thkrz/SenMei3000/tools/ryujin/Ryujin.png

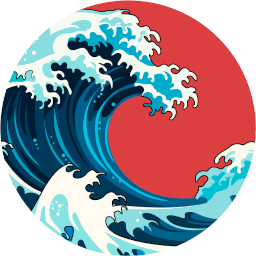
tools/ryujin/Ryujin.png
