thkrz/SenMei3000/www/html/fig/MainPro.png

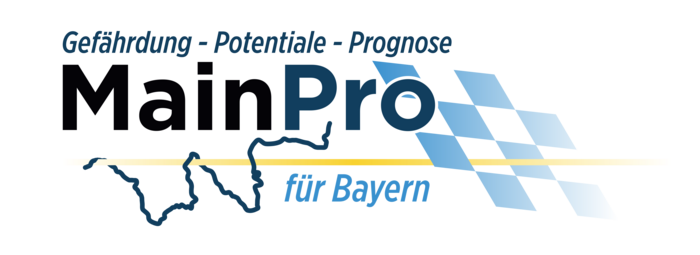
www/html/fig/MainPro.png
