thkrz/SenMei3000/pieces.xlsx

Sheet: Stückliste
Komponente | Bezeichnung | Stückpreis | Menge | Gesamt | Anzahl Stationen
Platine A | https://aisler.net/julius-maximilian-universitat-wurzburg/messstation/ryujin |  | 10 | 1287.21 €
Gehäuse B | https://taf-case.de/TAF-CASE-200-Staub-und-wasserdicht-IP67/1000000082 | 49.90 € | 10 | 499.00 €
MCU | https://www.reichelt.de/de/de/shop/produkt/arduino_mkr_nb_1500_samd21_cortex-m0_32_bit_arm-286746 | 83.60 € | 10 | 836.00 €
Buchse | https://www.reichelt.de/de/de/shop/produkt/einbausteckverbinder_m8_4_pol_kupplung_0_5_m-223096 | 7.55 € | 70 | 528.50 €
Buchse Solar | https://www.reichelt.de/de/de/shop/produkt/quicklock-einbaukupplung_-_groesse_12_2_pol-239487 | 3.45 € | 10 | 34.50 €
Solarpanel | https://solarv.de/enjoysolar-Monokristallines-Solarmodul-20W-12V-2-adriges-Solarkabel-1m1mm | 27.95 € | 0 | 0.00 €
Batterie | https://www.conrad.de/de/p/vision-akkus-cp12120d-cp12120d-bleiakku-12-v-12-ah-blei-vlies-agm-b-x-h-x-t-151-x-101-x-98-mm-flachstecker-6-35-mm-w-377145.html | 59.99 € | 0 | 0.00 €
 |  |  |  | 3185.21 €
 |  |  |  | 318.52 €

Sheet: Eq
THERMISTOR |  |  | V_BAT
V_REF | 3.3 |  | V_BAT | 13.3 |  |  | L | 2.3 | 13.8
RTH_COLD | 42.47 | k | R1 | 82.00 | k |  | T | 0
RTH_HOT | 3.02 | k | R2 | 437.33 | k | 390
V_LTF | 2
V_TCO | 1 |  | V_REAL | 12.09
^
RT1 | 5.36 | k
RT2 | 10.24 | k | V_MPPSET
 |  |  | V_MMPSET | 17.83
 |  |  | R3 | 499
 |  |  | R4 | 36
