thkrz/SenMei3000/kicad/Ryujin/3dmodels/AS11CH.stp

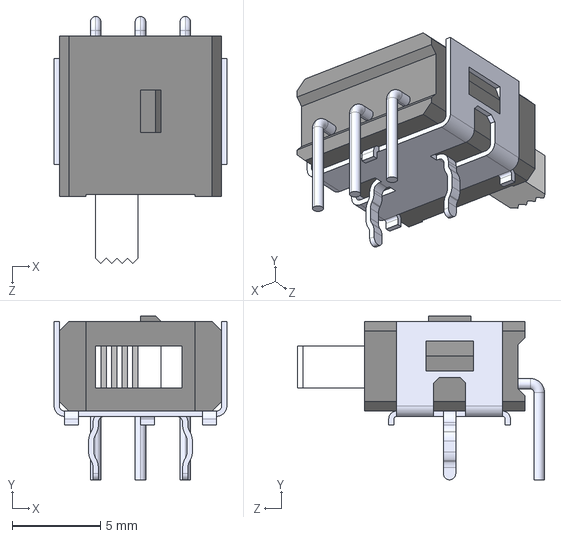
[picture p3: CAD file, 2025-09-05]
kicad/Ryujin/3dmodels/AS11CH.stp
9.80 x 9.28 x 14.0 mm
