thkrz/SenMei3000/kicad/SonTinh/3dmodels/STC31-C-R3.stp

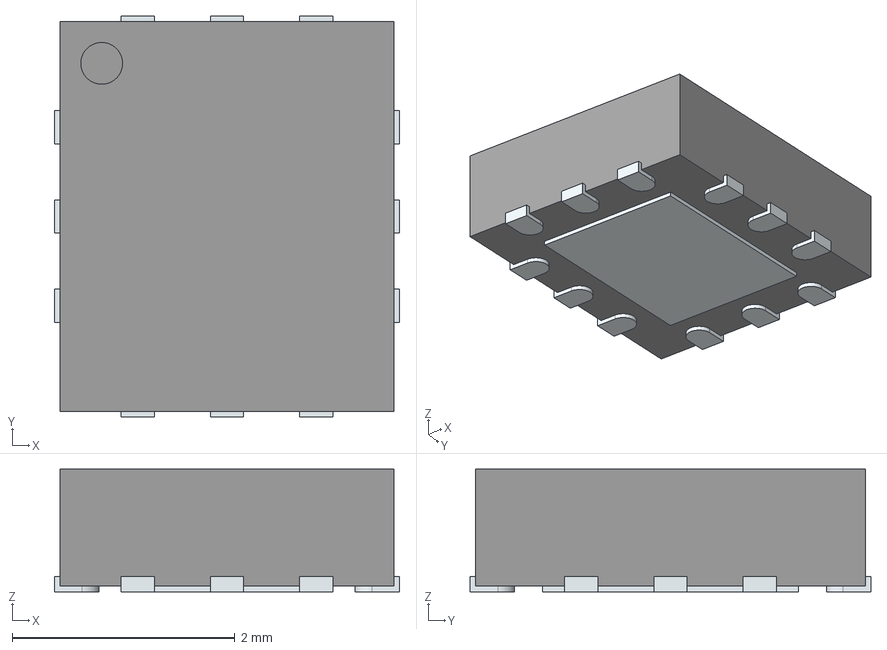
[picture p4: CAD file, 2025-08-25]
kicad/SonTinh/3dmodels/STC31-C-R3.stp
3.10 x 3.60 x 1.10 mm
ThermalPin
PinsArrayLR
PinsArrayTB
