thkrz/SenMei3000/kicad/Ryujin/3dmodels/EEF-CX0J221R.stp

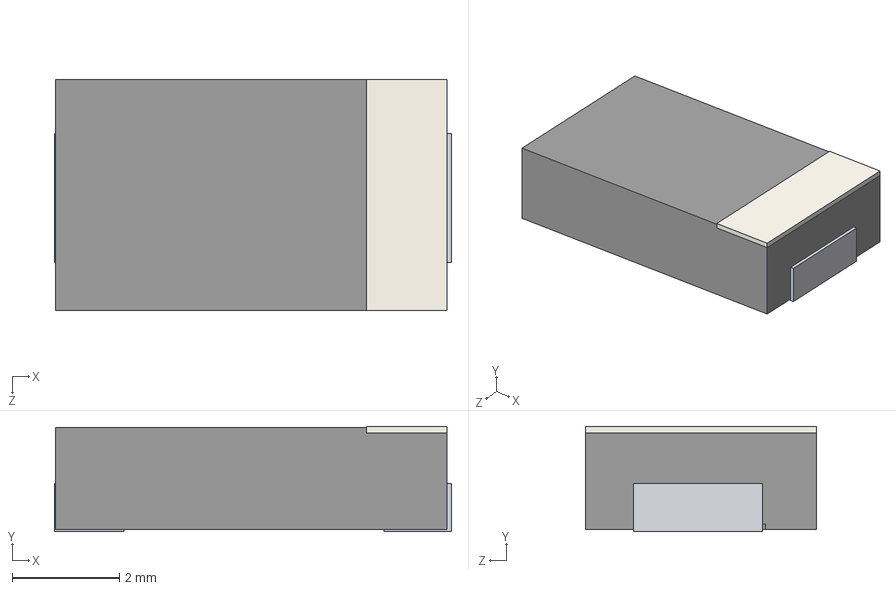
[picture p5: CAD file, 2025-09-04]
kicad/Ryujin/3dmodels/EEF-CX0J221R.stp
7.40 x 1.96 x 4.30 mm
EEFSX0D181ER_4
EEFSX0D181ER_3
