thkrz/SenMei3000/kicad/SonTinh/3dmodels/SHT35-DIS-F2.5kS.stp

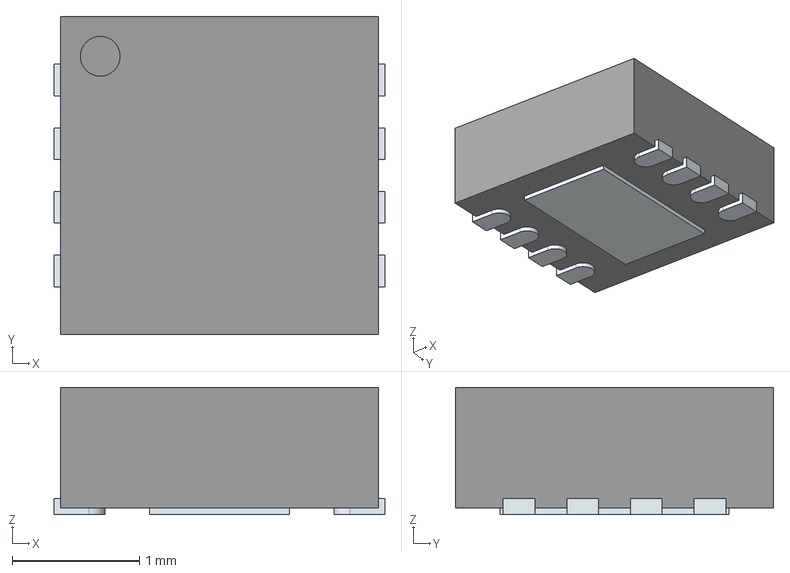
[picture p6: CAD file, 2025-08-25]
kicad/SonTinh/3dmodels/SHT35-DIS-F2.5kS.stp
2.60 x 2.50 x 1.00 mm
ThermalPin
PinsArrayLR
