thkrz/SenMei3000/kicad/Ryujin/3dmodels/T522V227M006ATE025.stp

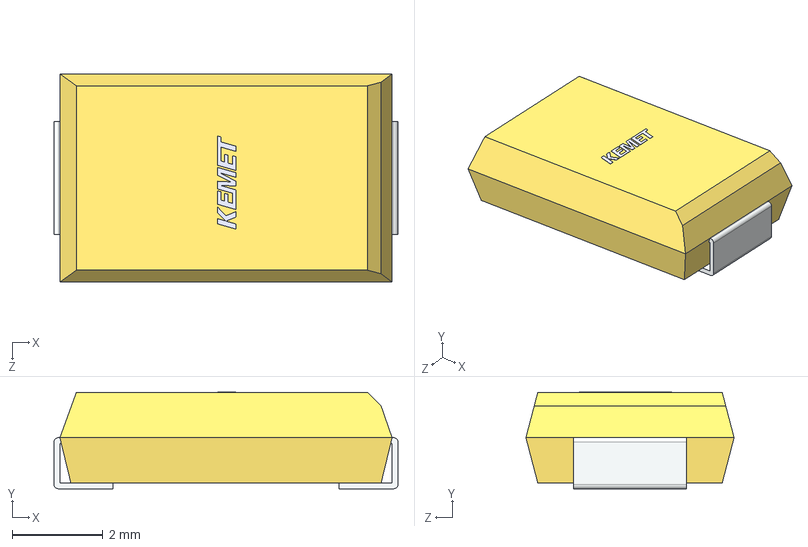
[picture p7: CAD file, 2025-09-04]
kicad/Ryujin/3dmodels/T522V227M006ATE025.stp
7.60 x 2.14 x 4.60 mm
