thkrz/SenMei3000/kicad/SonTinh/3dmodels/BMP384.stp

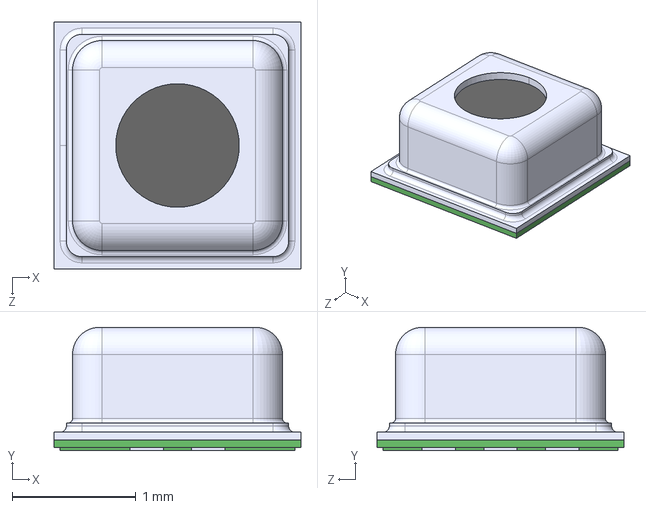
[picture p8: CAD file, 2025-08-25]
kicad/SonTinh/3dmodels/BMP384.stp
2.00 x 1.00 x 2.00 mm
