thkrz/SenMei3000/kicad/Ryujin/3dmodels/SI7288DP-T1-GE3.stp

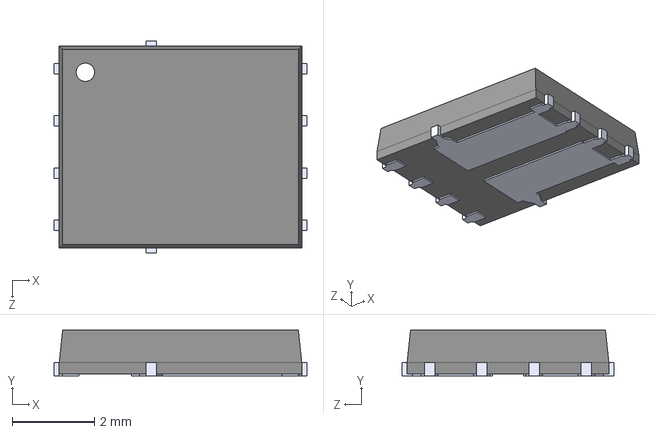
[picture p9: CAD file, 2025-03-24]
kicad/Ryujin/3dmodels/SI7288DP-T1-GE3.stp
6.15 x 1.12 x 5.16 mm
