thkrz/SenMei3000/kicad/Ryujin/3dmodels/PDS1040-13.stp

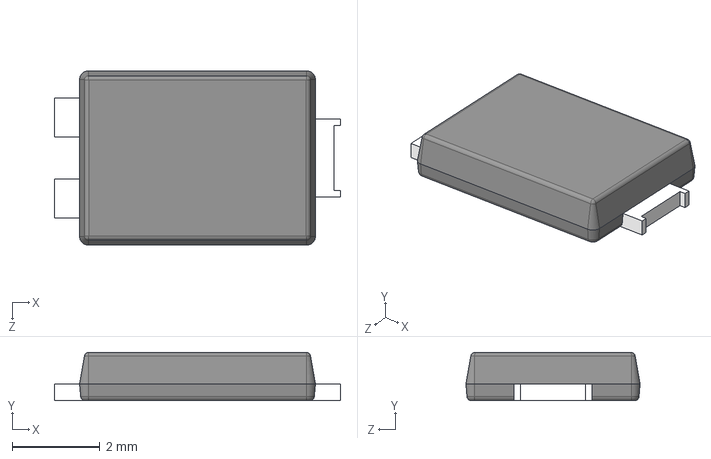
[picture p10: CAD file, 2025-03-16]
kicad/Ryujin/3dmodels/PDS1040-13.stp
6.51 x 1.10 x 3.97 mm
