thkrz/SenMei3000/kicad/Ryujin/3dmodels/IHLP2525CZER100MA1.stp

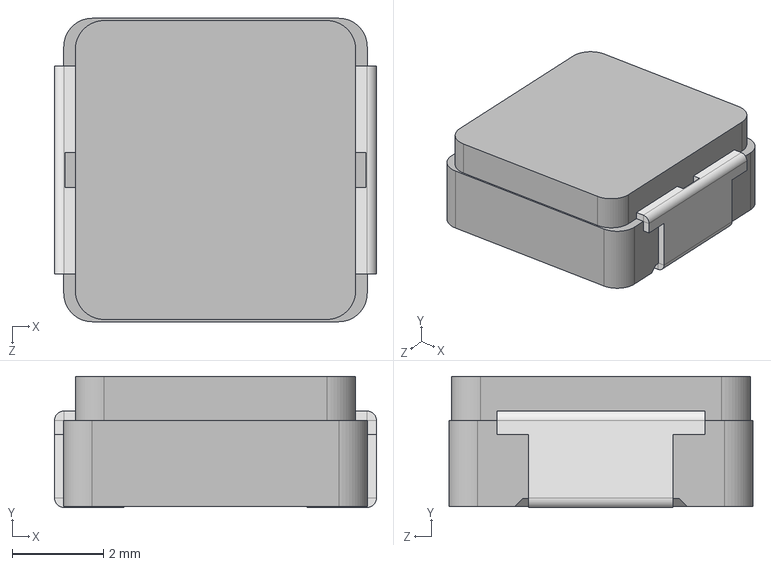
[picture p11: CAD file, 2025-03-16]
kicad/Ryujin/3dmodels/IHLP2525CZER100MA1.stp
7.08 x 2.88 x 6.67 mm
