thkrz/SenMei3000/kicad/Ryujin/3dmodels/Molex_Micro-Fit_3.0_43650-0415_1x04_P3.00mm_Vertical.stp

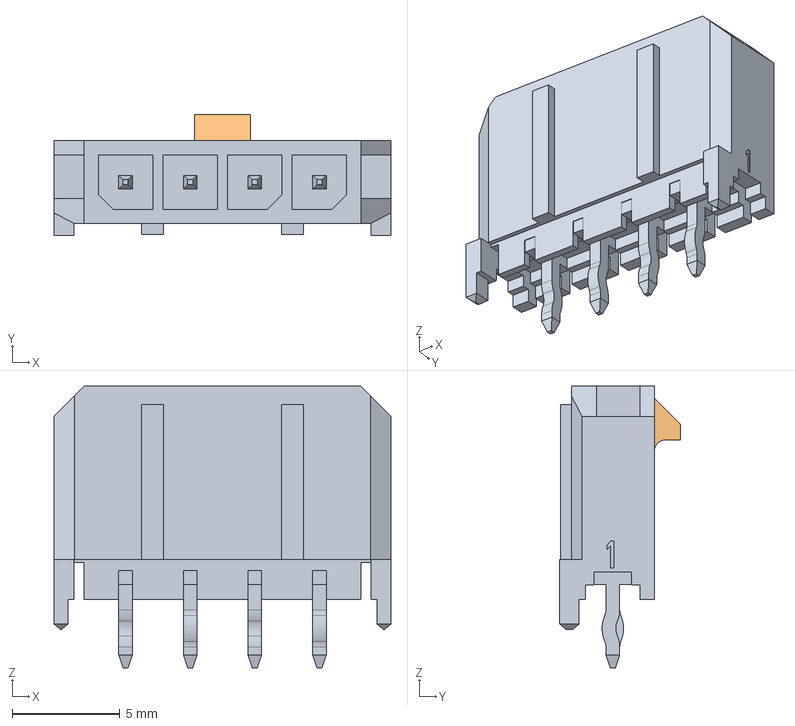
[picture p12: CAD file, 2025-03-16]
kicad/Ryujin/3dmodels/Molex_Micro-Fit_3.0_43650-0415_1x04_P3.00mm_Vertical.stp
15.7 x 5.61 x 13.1 mm
