thkrz/SenMei3000/kicad/Ryujin/3dmodels/PT_25_4_75_V.stp

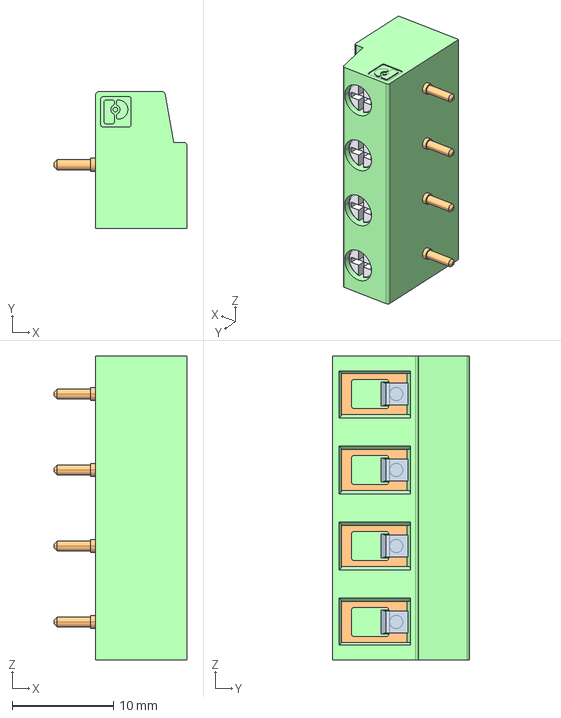
[picture p13: CAD file, 2025-03-15]
kicad/Ryujin/3dmodels/PT_25_4_75_V.stp
13.1 x 13.5 x 30.0 mm
