thkrz/SenMei3000/kicad/AoQin/3dmodels/1861959.stp

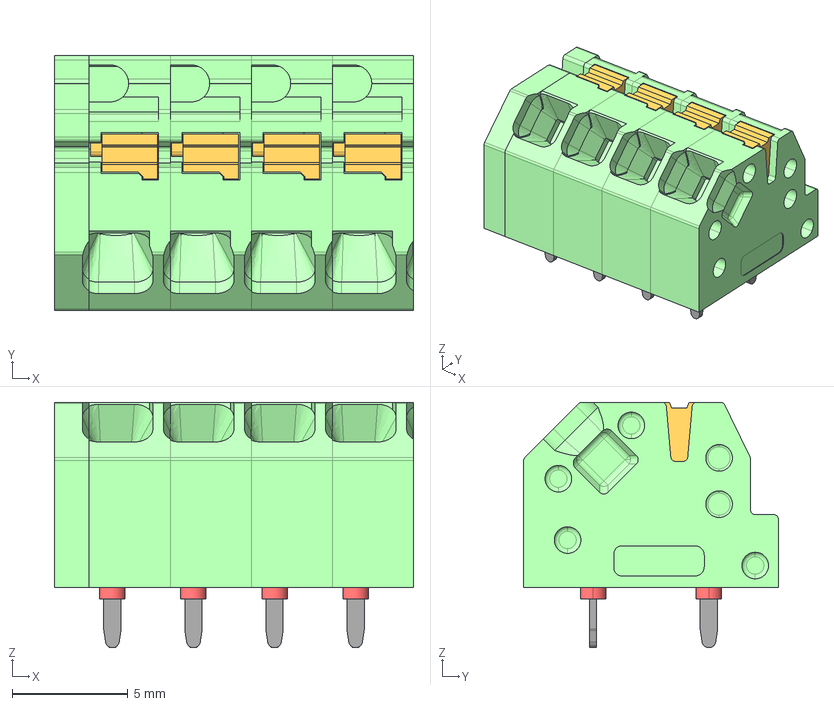
[picture p14: CAD file, 2025-04-04]
kicad/AoQin/3dmodels/1861959.stp
15.5 x 11.0 x 10.6 mm
Bohrloch x 8
SPTAF_1-3.5_housing.2 x 4
SPTAF-0-DKL.1
