thkrz/SenMei3000/kicad/Ryujin/3dmodels/1822972.stp

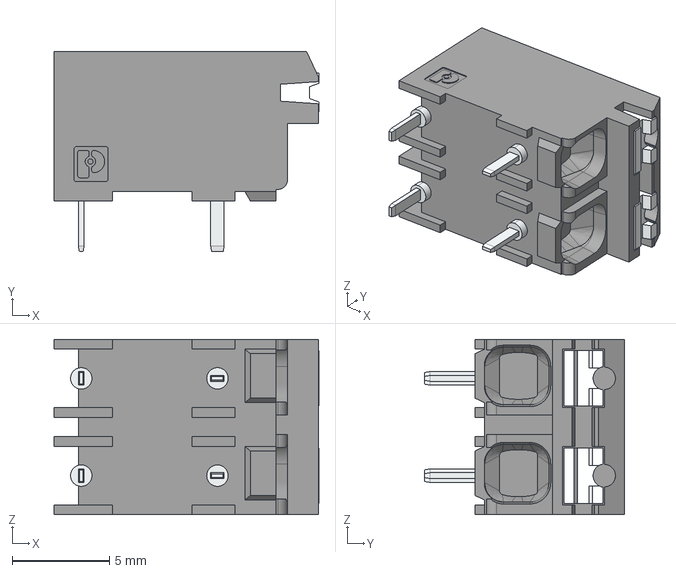
[picture p15: CAD file, 2025-03-20]
kicad/Ryujin/3dmodels/1822972.stp
13.6 x 10.3 x 9.00 mm
