thkrz/SenMei3000/kicad/Ryujin/3dmodels/1712724.stp

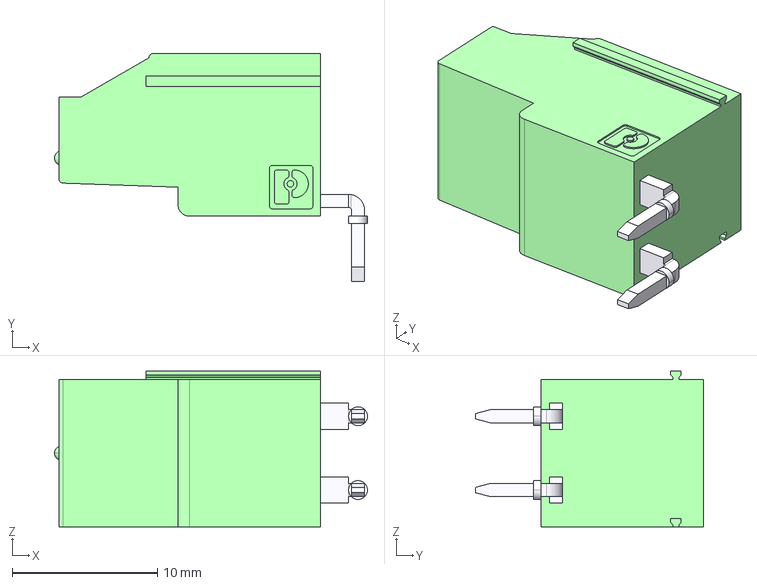
[picture p16: CAD file, 2025-03-20]
kicad/Ryujin/3dmodels/1712724.stp
21.5 x 15.7 x 10.7 mm
