thkrz/SenMei3000/kicad/Ryujin/3dmodels/BQ24650RVAR.stp

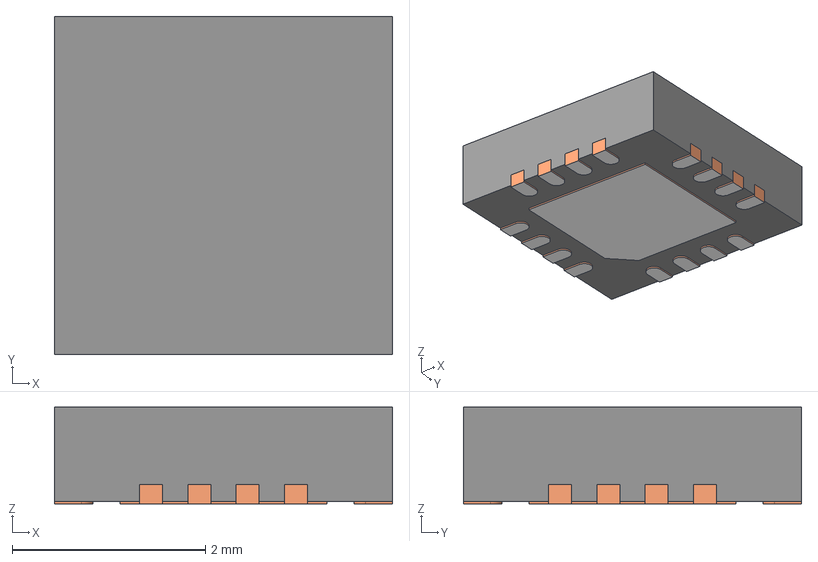
[picture p17: CAD file, 2025-03-15]
kicad/Ryujin/3dmodels/BQ24650RVAR.stp
3.50 x 3.50 x 1.00 mm
BODY-QFN
FRAME-RVA0016A
PIN1-ID
