thkrz/SenMei3000/kicad/Ryujin/plots/Ryujin-B_Paste.pdf

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

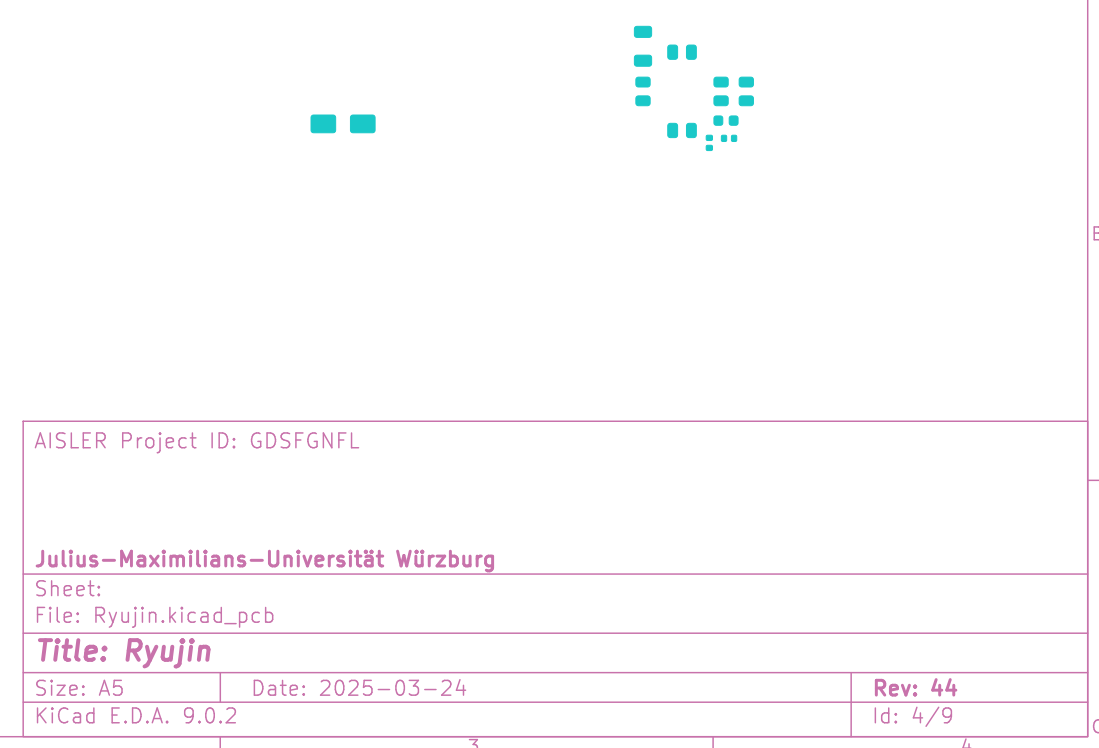
[picture p20: page 1]
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
