thkrz/SenMei3000/kicad/Ryujin/plots/Ryujin-B_Silkscreen.pdf

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

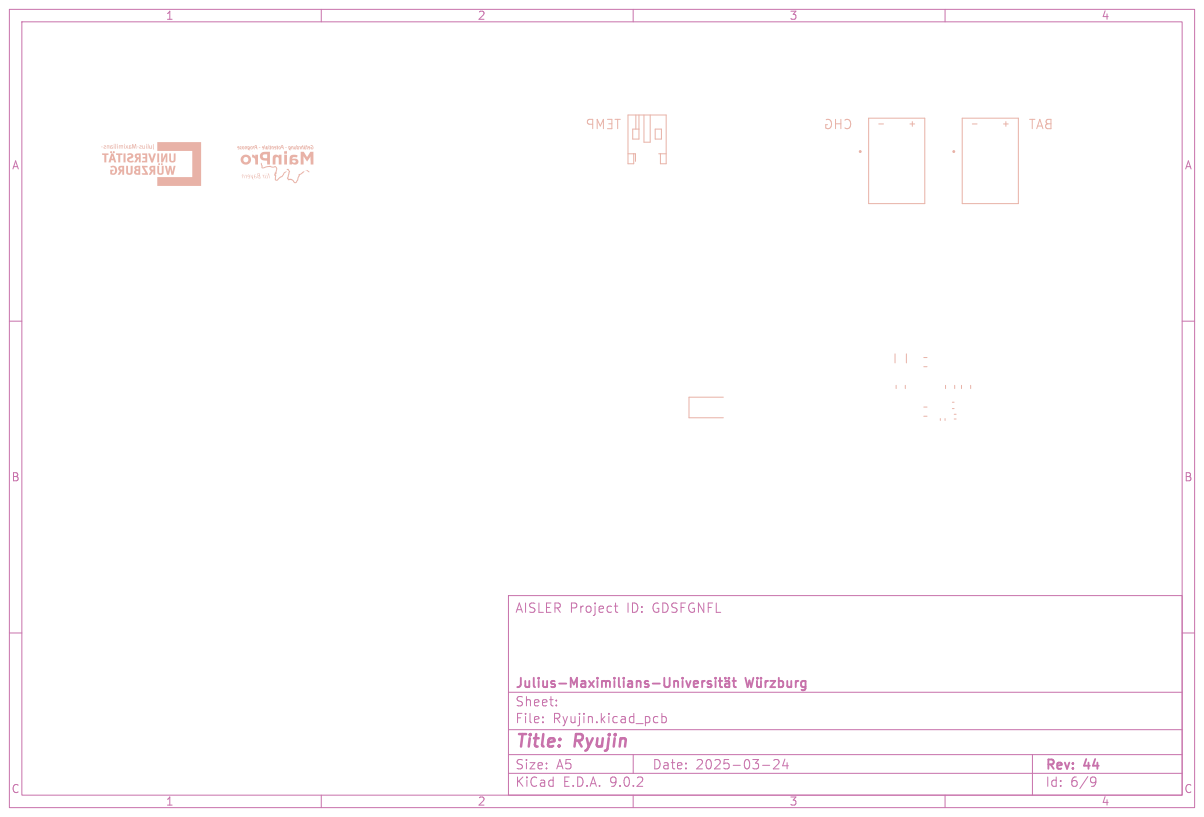
[picture p21: page 1]
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
