thkrz/SenMei3000/kicad/Ryujin/Ryujin.kicad_pcb

## KiCad design kicad/Ryujin/Ryujin.kicad_pcb (2025-09-16)

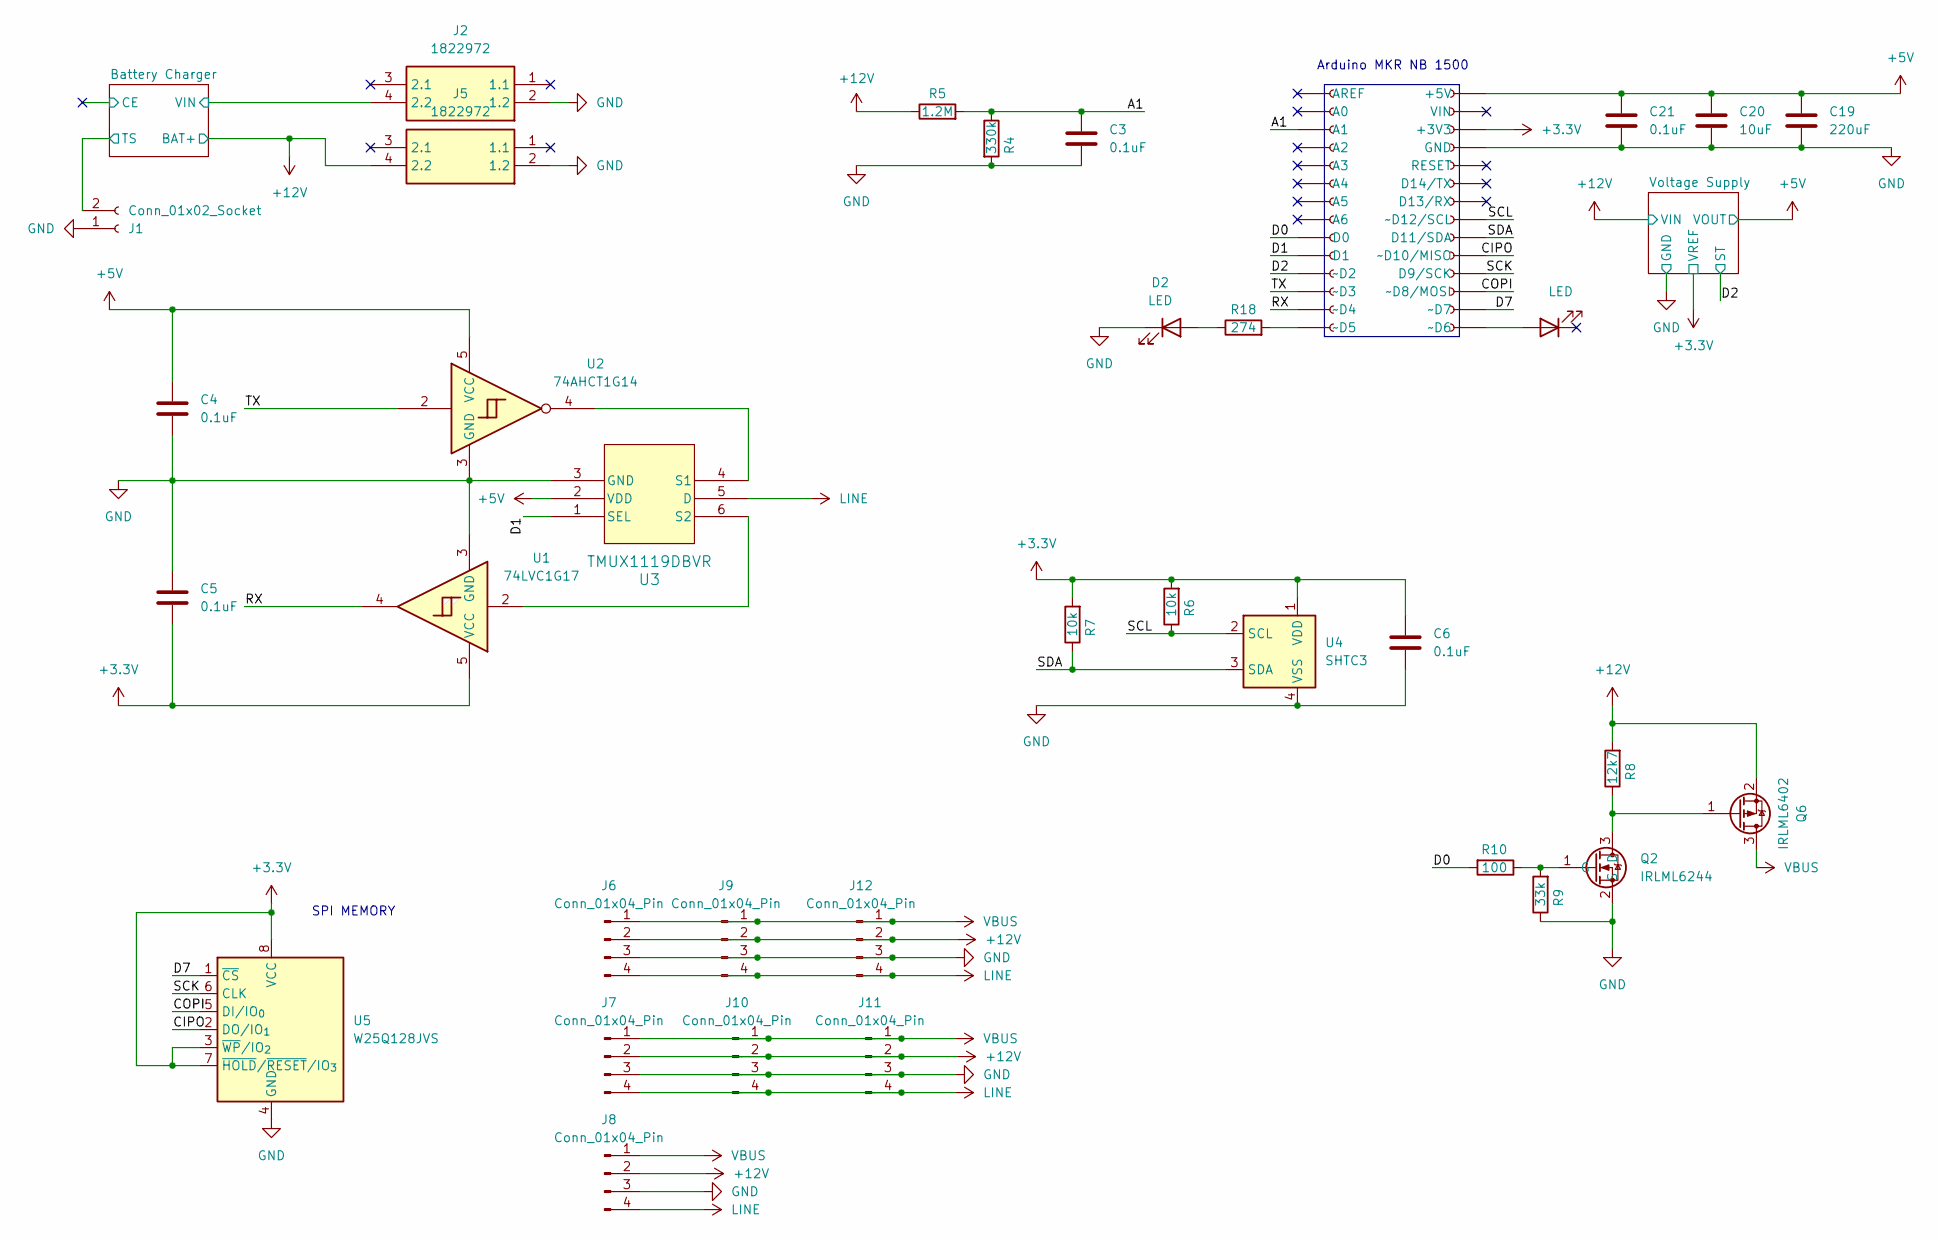
[picture p27: schematic Ryujin.kicad_sch]

Parts:
C3, C4, C5, C6, C21: 0.1uF; C_0603_1608Metric; MPN 0.1uF 6.3V 0603
C19: 220uF; EEFCX0J101R; MPN EEFCX0J221R
C20: 10uF; C_0805_2012Metric; MPN 10uF 10V 0805
D2: LED; LED_0603_1608Metric; MPN LTST-C194KFKT
D7: LED; LED_0603_1608Metric
J1: Conn_01x02_Socket; JST_PH_S2B-PH-K_1x02_P2.00mm_Horizontal; MPN S2B-PH-K-S
J2, J5: 1822972; Manufacturer_Part_Number 1822972; Mouser Part Number 651-1822972
J3, J4: Conn_01x14_Socket; 65342372; MPN 6-534237-2
J6, J7, J8, J9, J10, J11, J12: Conn_01x04_Pin; Molex_KK-254_AE-6410-04A_1x04_P2.54mm_Vertical; MPN 22272041
Q2: IRLML6244; SOT-23; MPN IRLML6244TRPBF
Q6: IRLML6402; SOT-23; MPN IRLML6402TRPBF
R4: 330k; R_0603_1608Metric; MPN 330k 0603
R5: 1.2M; R_0603_1608Metric; MPN 1.2M 0603
R6, R7: 10k; R_0603_1608Metric; MPN 10k 0603
R8: 12k7; R_0603_1608Metric; MPN 12.7k 0603
R9: 33k; R_0603_1608Metric; MPN 33k 0603
R10: 100; R_0603_1608Metric; MPN 100 0603
R18: 274; R_0603_1608Metric; MPN 274 0603
U1: 74LVC1G17; SOT-23-5; MPN SN74LVC1G17DBVT
U2: 74AHCT1G14; SOT-23-5; MPN SN74AHCT1G14DBVR
U3: TMUX1119DBVR; TMUXDBVR
U4: SHTC3; Sensirion_DFN-4-1EP_2x2mm_P1mm_EP0.7x1.6mm; MPN SHTC3
U5: W25Q128JVS; SOIC-8_5.3x5.3mm_P1.27mm; MPN W25Q128JVSIQ TR

Connections:
+3.3V: C5.2, C6.1, J4.3 (+3V3), R6.2, R7.2, U1.5 (VCC), U4.1 (VDD), U5.3 (~WP/IO_{2}), U5.7 (~HOLD/~RESET/IO_{3}), U5.8 (VCC); also elsewhere on the board
+5V: C4.1, C19.1, C20.1, C21.1, J4.1 (+5V), U2.5 (VCC), U3.2 (VDD); also elsewhere on the board
+12V: J5.4 (2.2), J6.2, J7.2, J8.2, J9.2, J10.2, J11.2, J12.2, Q6.2 (S), R5.1, R8.2; also elsewhere on the board
/A1: C3.1, J3.3 (A1), R4.1, R5.2
/Battery Charger/TS: J1.2; also elsewhere on the board
/Battery Charger/VIN: J2.4 (2.2); also elsewhere on the board
/CIPO: J4.10 (~D10/MISO), U5.2 (DO/IO_{1})
/COPI: J4.12 (~D8/MOSI), U5.5 (DI/IO_{0})
/D0: J3.9 (D0), R10.2
/D1: J3.10 (D1), U3.1 (SEL)
/D2: J3.11 (~D2); also elsewhere on the board
/D7: J4.13 (~D7), U5.1 (~CS)
/RX: J3.13 (~D4), U1.4
/SCK: J4.11 (D9/SCK), U5.6 (CLK)
/SCL: J4.8 (~D12/SCL), R6.1, U4.2 (SCL)
/SDA: J4.9 (D11/SDA), R7.1, U4.3 (SDA)
/TX: J3.12 (~D3), U2.2
GND: C3.2, C4.2, C5.1, C6.2, C19.2, C20.2, C21.2, D2.1 (K), J1.1, J2.2 (1.2), J4.4 (GND), J5.2 (1.2), J6.3, J7.3, J8.3, J9.3, J10.3, J11.3, J12.3, Q2.2 (S), R4.2, R9.1, U1.3 (GND), U2.3 (GND), U3.3 (GND), U4.4 (VSS), U5.4 (GND); also elsewhere on the board
LINE: J6.4, J7.4, J8.4, J9.4, J10.4, J11.4, J12.4, U3.5 (D)
unnamed: D2.2 (A), R18.1
unnamed: J3.14 (~D5), R18.2
unnamed: D7.2 (A), J4.14 (~D6)
unnamed: Q2.3 (D), Q6.1 (G), R8.1
unnamed: Q2.1 (G), R9.2, R10.1
unnamed: U2.4, U3.4 (S1)
unnamed: U1.2, U3.6 (S2)
VBUS: J6.1, J7.1, J8.1, J9.1, J10.1, J11.1, J12.1, Q6.3 (D)

Notes on the sheet:
SPI MEMORY
Arduino MKR NB 1500

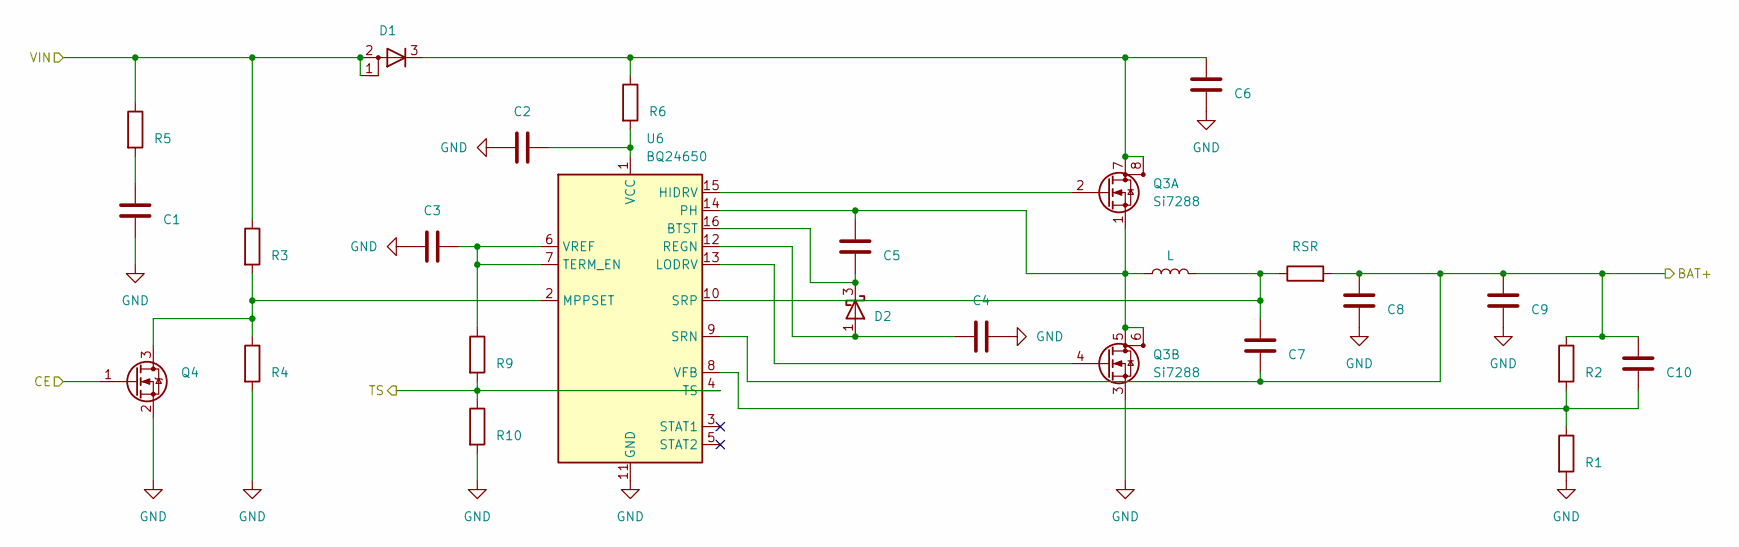
[picture p28: schematic Battery_Charger.kicad_sch, Ryujin]

Parts:
C7: C1; C_1210_3225Metric; MPN 2.2uF 50V 1210
C8: C2; C_0805_2012Metric; MPN 1uF 35V 0805
C9: C6; C_1210_3225Metric; MPN 10uF 35V 1210
C10: C4; C_0805_2012Metric; MPN 1uF 35V 0805
C11: C5; C_0805_2012Metric; MPN C0805C104K6RACTU
C12: C8; C_1210_3225Metric; MPN 10uF 35V 1210
C13: C7; C_0805_2012Metric; MPN C0805C104K6RACTU
C14: C10; C_0603_1608Metric; MPN 22pF 50V 0603
C15: C3; C_0805_2012Metric; MPN 1uF 35V 0805
C16: C9; C_Elec_4x5.4; MPN EEEFK1V4R7AR
D5: D1; PDS104013; MPN PDS1040-13
D6: D2; SOT-23; MPN BAT54
L1: L; L_Vishay_IHLP-2525; MPN IHLP2525CZER100MA1
Q3: Si7288; SI7288DPT1GE3; MPN SI7288DP-T1-GE3
Q4: 2N7002; SOT-23
R1: R5; R_2512_6332Metric; MPN 2 5% 1W
R2: R3; R_0402_1005Metric; MPN 499k 0402
R3: R4; R_0402_1005Metric; MPN 36k 0402
R13: R6; R_1206_3216Metric; MPN 10 1206 0.25W
R14: R9; R_0402_1005Metric; MPN 5.23k 0402
R15: R1; R_0402_1005Metric; MPN 97.6k 0402
R16: R2; R_0402_1005Metric; MPN 536k 0402
R17: R10; R_0402_1005Metric; MPN 30.1k 0402
RSR1: RSR; R_1206_3216Metric; MPN WSL1206R0200DEA
U6: BQ24650; Texas_RVA_VQFN-16-1EP_3.5x3.5mm_P0.5mm_EP2.14x2.14mm_Therma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; MPN BQ24650RVAR

Connections:
+12V: C12.1, C13.1, C14.1, C16.1, R16.1, RSR1.2, U6.9 (SRN); also elsewhere on the board
/Battery Charger/TS: R14.2, R17.1, U6.4 (TS); also elsewhere on the board
/Battery Charger/VIN: D5.1 (A), D5.2 (A), R1.1, R2.1; also elsewhere on the board
GND: C7.2, C8.1, C9.2, C10.2, C12.2, C15.1, C16.2, Q3.3 (S), Q4.2 (S), R3.2, R15.2, R17.2, U6.11 (GND), U6.17 (GND); also elsewhere on the board
unnamed: C7.1, R1.2
unnamed: C9.1, D5.3 (K), Q3.7 (D), Q3.8 (D), Q3.9 (D), Q3.11 (D), R13.1
unnamed: C10.1, D6.1 (A), U6.12 (REGN)
unnamed: C11.1, D6.3 (K), U6.16 (BTST)
unnamed: Q3.2 (G), U6.15 (HIDRV)
unnamed: C11.2, L1.1, Q3.1 (S), Q3.5 (D), Q3.6 (D), Q3.10 (D), Q3.12 (D), U6.14 (PH)
unnamed: Q3.4 (G), U6.13 (LODRV)
unnamed: Q4.3 (D), R2.2, R3.1, U6.2 (MPPSET)
unnamed: C13.2, L1.2, RSR1.1, U6.10 (SRP)
unnamed: C15.2, R14.1, U6.6 (VREF), U6.7 (TERM_EN)
unnamed: C8.2, R13.2, U6.1 (VCC)
unnamed: C14.2, R15.1, R16.2, U6.8 (VFB)

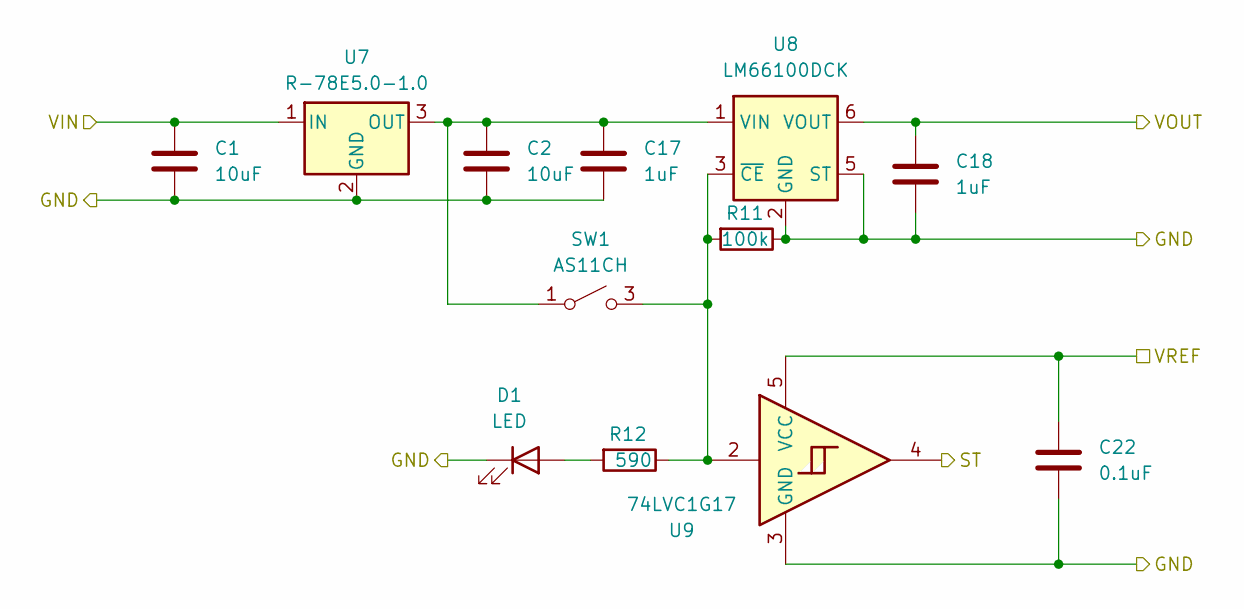
[picture p29: schematic volt_supp.kicad_sch, Ryujin]

Parts:
C1: 10uF; C_1206_3216Metric; MPN 10uF 16V 1206
C2: 10uF; C_0805_2012Metric; MPN 10uF 6.3V 0805
C17, C18: 1uF; C_0603_1608Metric; MPN 1uF 6.3V 0603
C22: 0.1uF; C_0603_1608Metric; MPN 0.1uF 6.3V 0603
D1: LED; LED_0603_1608Metric; MPN LTST-C193KRKT-5A
R11: 100k; R_0603_1608Metric; MPN 100k 0603
R12: 590; R_0603_1608Metric; MPN 590 0603
SW1: AS11CH
U7: R-78E5.0-1.0; Converter_DCDC_RECOM_R-78E-0.5_THT
U8: LM66100DCK; SOT-363_SC-70-6; MPN LM66100DCKT
U9: 74LVC1G17; SOT-23-5; MPN SN74LVC1G17DBVT

Connections:
+3.3V: C22.2, U9.5 (VCC); also elsewhere on the board
+5V: C18.1, U8.6 (VOUT); also elsewhere on the board
+12V: C1.1, U7.1 (IN); also elsewhere on the board
/D2: U9.4; also elsewhere on the board
GND: C1.2, C2.2, C17.2, C18.2, C22.1, D1.1 (K), R11.1, U7.2 (GND), U8.2 (GND), U8.5 (ST), U9.3 (GND); also elsewhere on the board
unnamed: D1.2 (A), R12.2
unnamed: C2.1, C17.1, SW1.1 (A), U7.3 (OUT), U8.1 (VIN)
unnamed: R11.2, R12.1, SW1.3 (B), U8.3 (~CE), U9.2

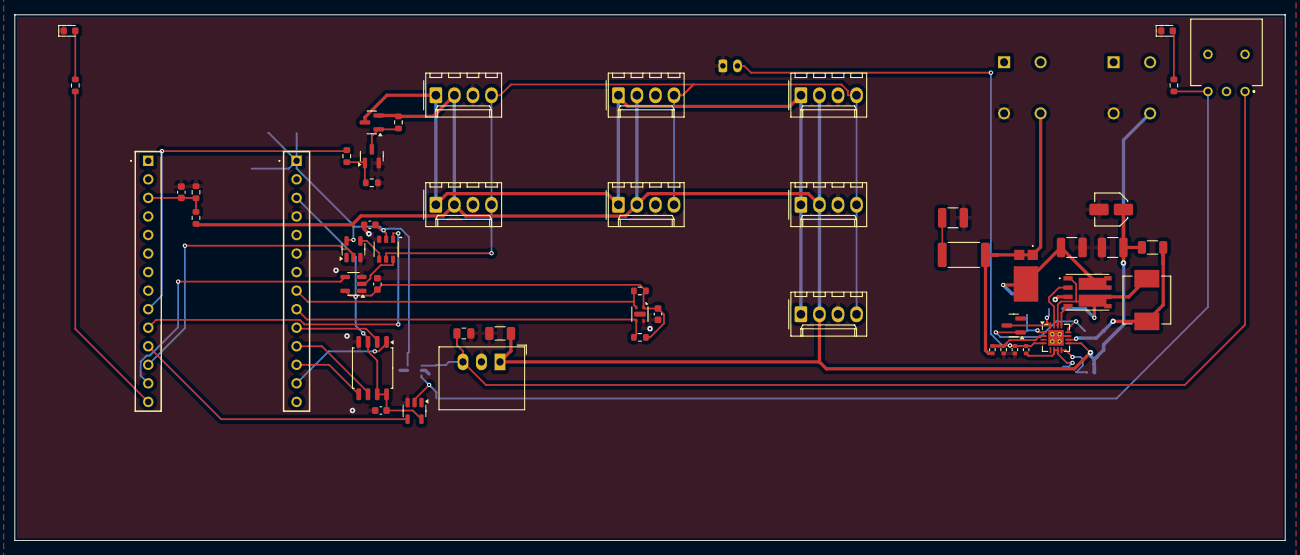
[picture p30: board Ryujin.kicad_pcb from above]

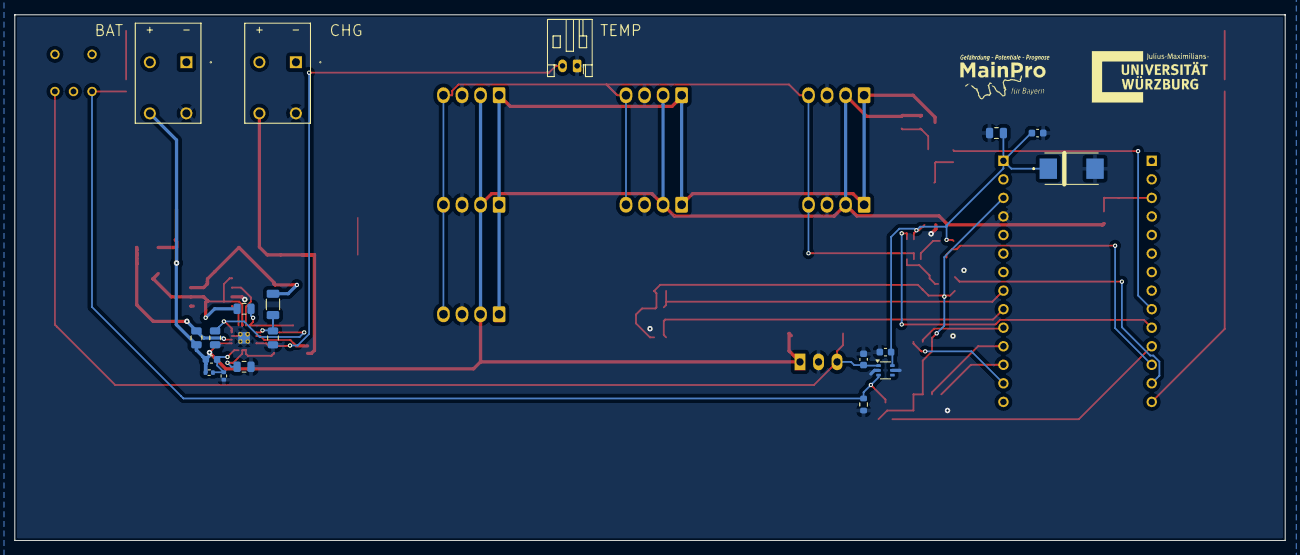
[picture p31: board Ryujin.kicad_pcb from below]

Board: 2 copper layers, 174.0 x 72.0 mm, 73 parts (21 on the bottom side), 41 nets.

Other parts of the board:
G1, G2: LOGO
