thkrz/SenMei3000/kicad/SonTinh/SonTinh.kicad_pcb

## KiCad design kicad/SonTinh/SonTinh.kicad_pcb (2025-09-12)

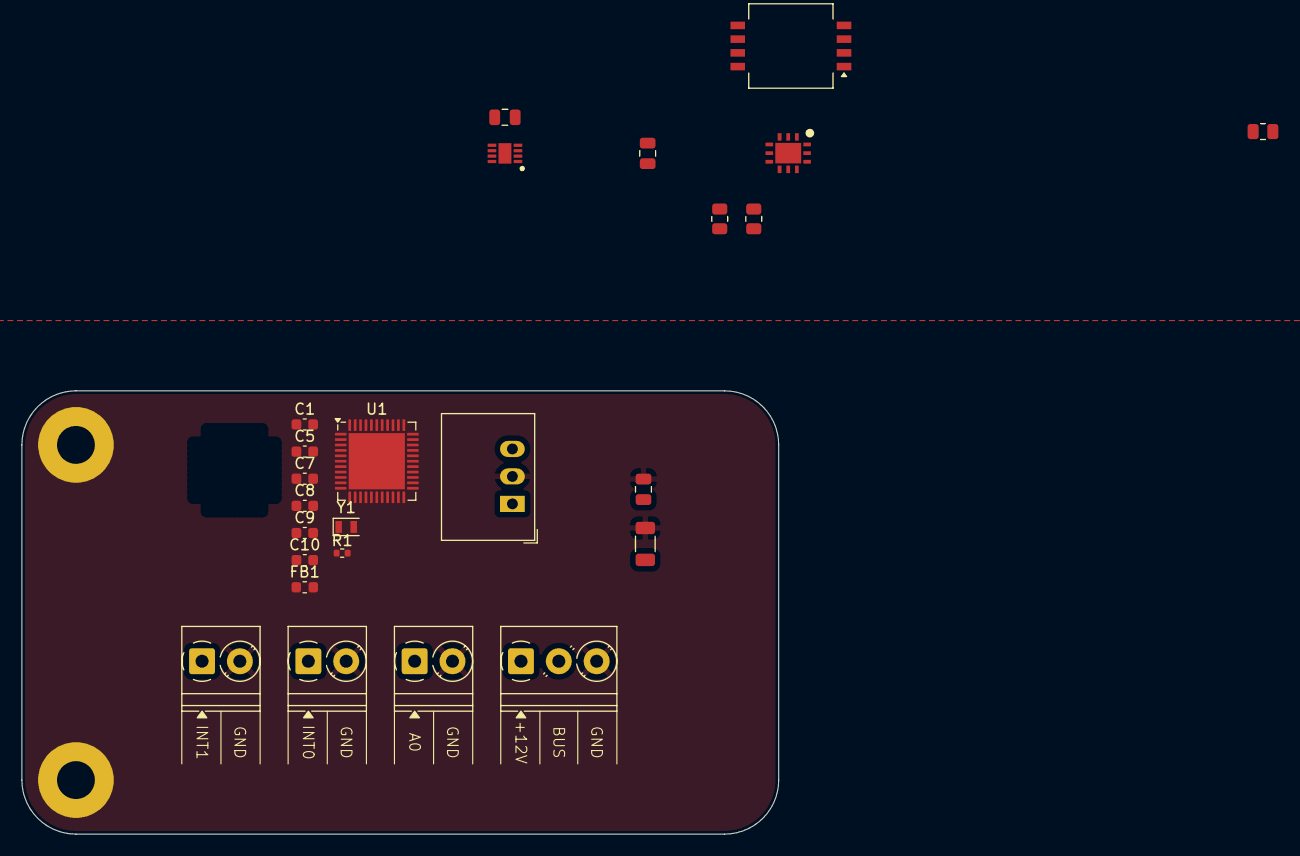
[picture p32: board SonTinh.kicad_pcb from above]

Board: 2 copper layers, 70.0 x 41.0 mm, 27 parts (0 on the bottom side), 10 nets, no tracks yet.

Parts:
C1, C5, C7, C8, C9, C10: C; C_0603_1608Metric
C2, C6: C; C_0805_2012Metric
C3: 10uF; C_1206_3216Metric
C4: 10uF; C_0805_2012Metric
FB1: FerriteBead; L_0603_1608Metric
H1, H2: MountingHole_Pad; MountingHole_3.5mm_Pad
IC1: SHT35-DIS-F2.5kS; SON50P250X250X100-9N-D
IC2: STC31-C-R3; QFN80P300X350X110-13N-D
J1, J2, J3: Screw_Terminal_01x02; TerminalBlock_Phoenix_PT-1,5-2-3.5-H_1x02_P3.50mm_Horizontal
J4: Screw_Terminal_01x03; TerminalBlock_Phoenix_PT-1,5-3-3.5-H_1x03_P3.50mm_Horizontal
R1: R; R_0402_1005Metric
R13: 100k; R_0805_2012Metric
R14, R15: 10k; R_0805_2012Metric
U1: ATmega32U4-M; QFN-44-1EP_7x7mm_P0.5mm_EP5.2x5.2mm
U3: MPXH6115A; Freescale_98ARH99066A
U7: R-78E5.0-1.0; Converter_DCDC_RECOM_R-78E-0.5_THT
Y1: Crystal; Crystal_SMD_2012-2Pin_2.0x1.2mm

Connections:
+5V: C2.2, C4.1, C6.2, IC1.5 (VDD), IC2.6 (VDD), R14.2, R15.2, U3.2 (Vcc), U7.3 (OUT)
+12V: C3.1, J4.1, U7.1 (IN)
/D7: J4.2, R13.2
/MCU/GND: C1.2, C5.2, C7.2, C8.2, C9.2, C10.2, R1.1, U1.5 (UGND), U1.15 (GND), U1.23 (GND), U1.35 (GND), U1.43 (GND), U1.45 (GND)
/MCU/VCC: C1.1, C5.1, C7.1, C8.1, C10.1, FB1.1, FB1.2, U1.2 (UVCC), U1.14 (VCC), U1.24 (AVCC), U1.34 (VCC), U1.44 (AVCC)
/SCL_5V: IC1.4 (SCL), IC2.4 (SCL), R14.1
/SDA_5V: IC1.1 (SDA), IC2.7 (SDA), R15.1
GND: C2.1, C3.2, C4.2, C6.1, H1.1, H2.1, IC1.2 (ADDR), IC1.7 (R), IC1.8 (VSS), IC1.9 (EP), IC2.1 (VSS_1), IC2.3 (ADDR), IC2.5 (VSS_2), IC2.9 (VSS_3), IC2.11 (VSS_4), IC2.13 (EP), J1.2, J2.2, J3.2, J4.3, R13.1, U3.3 (GND), U7.2 (GND)
unnamed: C9.1, U1.42 (AREF)
unnamed: R1.2, U1.13 (~RESET)
