thkrz/SenMei3000/kicad/AoQin/AoQin.kicad_pcb

## KiCad design kicad/AoQin/AoQin.kicad_pcb (2025-04-04)

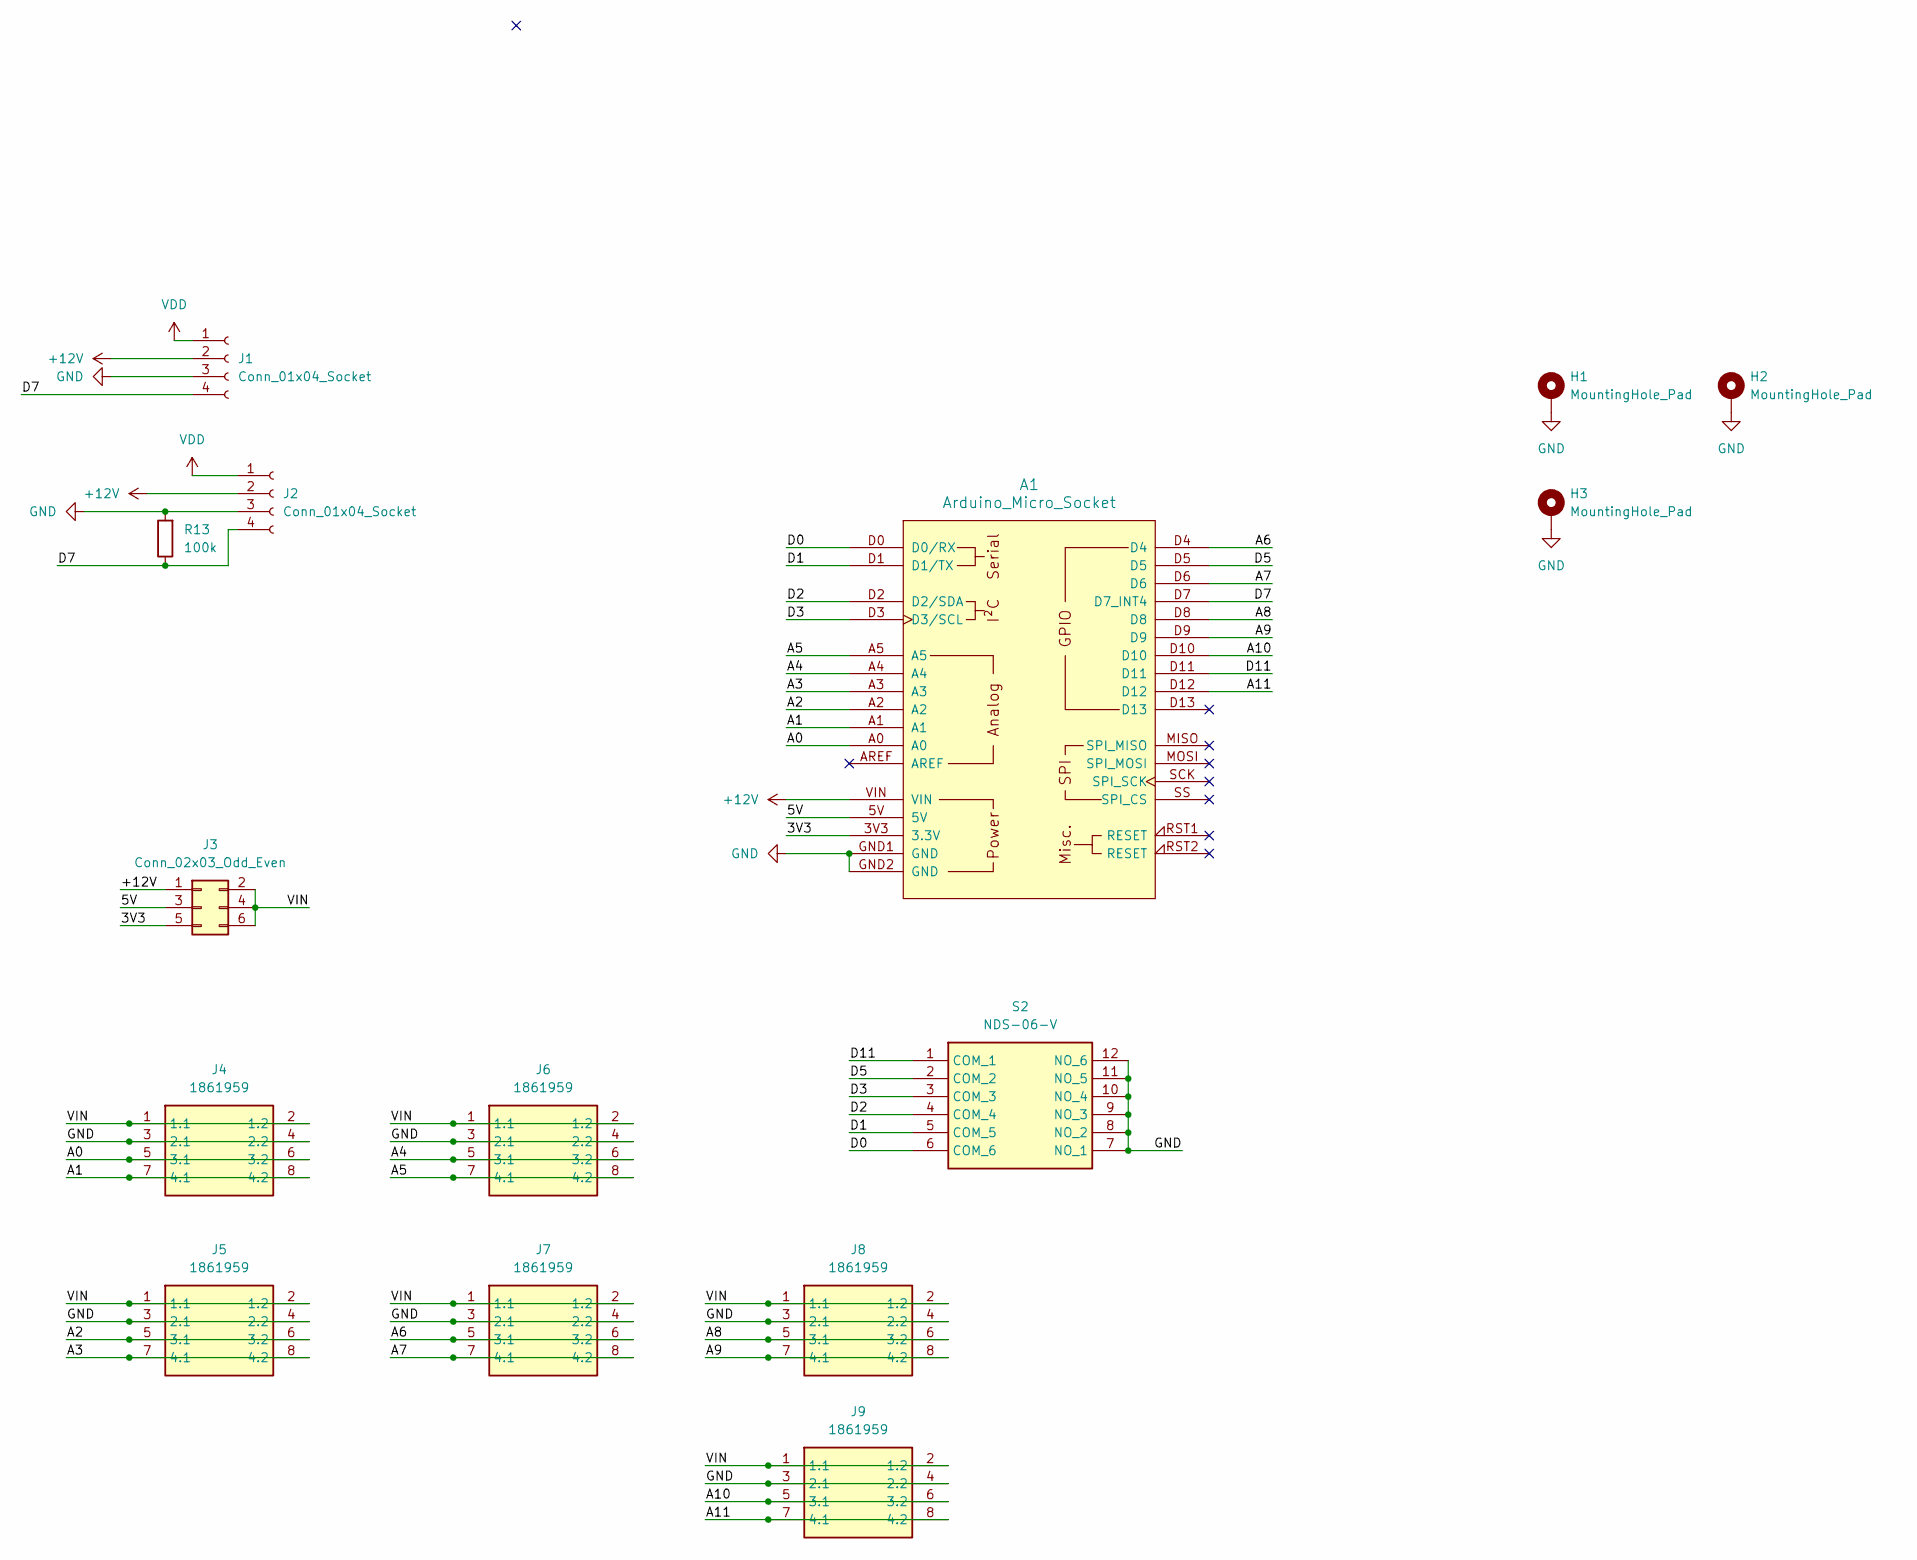
[picture p33: schematic AoQin.kicad_sch, A2SDI12]

Parts:
A1: Arduino_Micro_Socket
H1, H2, H3: MountingHole_Pad; MountingHole_3.5mm_Pad
J1, J2: Conn_01x04_Socket; SolderWire-0.5sqmm_1x04_P4.6mm_D0.9mm_OD2.1mm
J3: Conn_02x03_Odd_Even; PinHeader_2x03_P2.54mm_Vertical
J4, J5, J6, J7, J8, J9: 1861959; Manufacturer_Part_Number 1861959; Mouser Part Number 651-1861959
R13: 100k; R_Axial_DIN0204_L3.6mm_D1.6mm_P7.62mm_Horizontal; MPN 100k
S2: NDS-06-V; NDS06V; Manufacturer_Part_Number NDS-06-V; Mouser Part Number N/A

Connections:
+12V: A1.VIN, J1.2, J2.2, J3.1
/3V3: A1.3V3 (3.3V), J3.5
/5V: A1.5V, J3.3
/A0: A1.A0, J4.5 (3.1), J4.6 (3.2)
/A1: A1.A1, J4.7 (4.1), J4.8 (4.2)
/A2: A1.A2, J5.5 (3.1), J5.6 (3.2)
/A3: A1.A3, J5.7 (4.1), J5.8 (4.2)
/A4: A1.A4, J6.5 (3.1), J6.6 (3.2)
/A5: A1.A5, J6.7 (4.1), J6.8 (4.2)
/A6: A1.D4, J7.5 (3.1), J7.6 (3.2)
/A7: A1.D6, J7.7 (4.1), J7.8 (4.2)
/A8: A1.D8, J8.5 (3.1), J8.6 (3.2)
/A9: A1.D9, J8.7 (4.1), J8.8 (4.2)
/A10: A1.D10, J9.5 (3.1), J9.6 (3.2)
/A11: A1.D12, J9.7 (4.1), J9.8 (4.2)
/D0: A1.D0 (D0/RX), S2.6 (COM_6)
/D1: A1.D1 (D1/TX), S2.5 (COM_5)
/D2: A1.D2 (D2/SDA), S2.4 (COM_4)
/D3: A1.D3 (D3/SCL), S2.3 (COM_3)
/D5: A1.D5, S2.2 (COM_2)
/D7: A1.D7 (D7_INT4), J1.4, J2.4, R13.1
/D11: A1.D11, S2.1 (COM_1)
/VIN: J3.2, J3.4, J3.6, J4.1 (1.1), J4.2 (1.2), J5.1 (1.1), J5.2 (1.2), J6.1 (1.1), J6.2 (1.2), J7.1 (1.1), J7.2 (1.2), J8.1 (1.1), J8.2 (1.2), J9.1 (1.1), J9.2 (1.2)
GND: A1.GND1 (GND), A1.GND2 (GND), H1.1, H2.1, H3.1, J1.3, J2.3, J4.3 (2.1), J4.4 (2.2), J5.3 (2.1), J5.4 (2.2), J6.3 (2.1), J6.4 (2.2), J7.3 (2.1), J7.4 (2.2), J8.3 (2.1), J8.4 (2.2), J9.3 (2.1), J9.4 (2.2), R13.2, S2.7 (NO_1), S2.8 (NO_2), S2.9 (NO_3), S2.10 (NO_4), S2.11 (NO_5), S2.12 (NO_6)
VDD: J1.1, J2.1

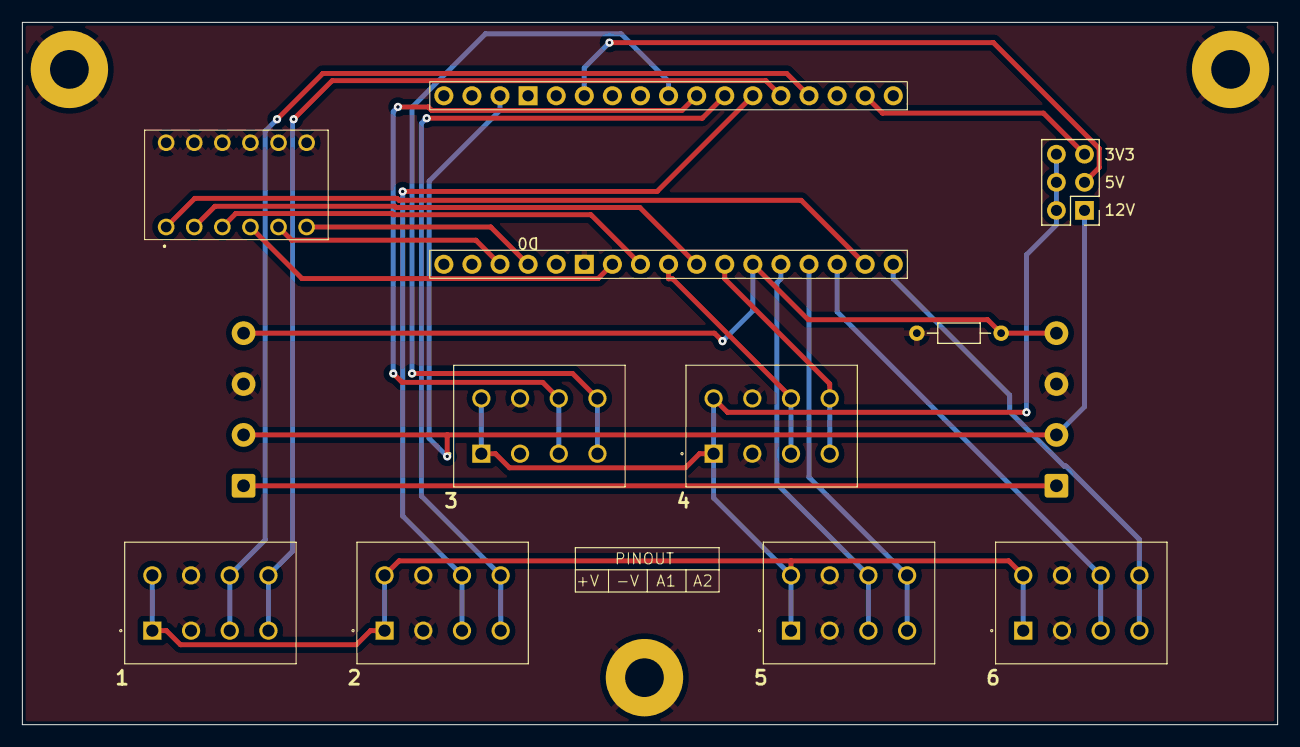
[picture p34: board AoQin.kicad_pcb from above]

Board: 2 copper layers, 113.5 x 63.5 mm, 15 parts (0 on the bottom side), 25 nets.
