thkrz/SenMei3000/arduino/sketches/A2SDI12/A2SDI12.ino

#include <EEPROM.h>
#include <SDI12.h>

#include "smt100.h"

#define CMD_LEN 8
#define EE_ADDR 0
#define NUM_CON 6

struct MKDS {
  char addr;
  bool active;
  float u[2];
};

MKDS mkds[NUM_CON];
SDI12 socket(13);
char buf[CMD_LEN];
int len = 0;
int pin[] = {
  A0, A1, A2, A3, A4, A5,
  A6, A7, A8, A9, A10, A11
};

void chkactive(int i) {
  int j = i * 2;
  pinMode(pin[j], INPUT_PULLUP);
  delay(10);
  mkds[i].active = analogRead(pin[j]) > 0;
  if (mkds[i].active)
    pinMode(pin[j], INPUT);
}

String data(int i) {
  static String s;

  MKDS *c = &mkds[i];
  s = "";
  for (int j = 0; j < 2; j++) {
    float a = tr[j](c->u[j]);
    if (a >= 0)
      s += "+";
    s += String(a);
  }
  return s;
}

int index(char a) {
  for (int i = 0; i < NUM_CON; i++)
    if (mkds[i].addr == a)
      return i;
  return -1;
}

void measure(int i) {
  MKDS *c = &mkds[i];
  int k = i * 2;
  for (int j = 0; j < 3; j++) {
    c->u[0] += analogRead(pin[k]);
    c->u[1] += analogRead(pin[k+1]);
  }
  c->u[0] *= 0.001629;
  c->u[1] *= 0.001629;
}

void rc() {
  char addr = buf[0];
  int i = index(addr);
  if (i < 0)
    return;
  if (len == 1)
    chkactive(i);
  if (!mkds[i].active)
    return;
  String r = "";
  bool m = false;
  if (len > 1)
    switch (buf[1]) {
    case 'I':
      r = INFO;
      break;
    case 'M':
      m = true;
      r = WAIT;
      break;
    case 'D':
      r = data(i);
      break;
    case 'A':
      addr = buf[2];
      mkds[i].addr = addr;
      EEPROM.write(EE_ADDR+i, addr);
      break;
    }

  String s = String(addr) + r + "\r\n";
  socket.sendResponse(s);
  if (m)
    measure(i);
}

void setup() {
  pinMode(LED_BUILTIN, OUTPUT);
  for (int i = 0; i < NUM_CON; i++)
    mkds[i].addr = EEPROM.read(EE_ADDR+i);
  socket.begin();
  delay(100);
  socket.forceListen();
}

void blink(bool fast) {
  uint32_t wait = fast ? 200 : 1000;
  digitalWrite(LED_BUILTIN, HIGH);
  delay(wait);
  digitalWrite(LED_BUILTIN, LOW);
  delay(wait);
}


void loop() {
  if (socket.available()) {
    char c = socket.read();
    if (c == '!') {
      socket.clearBuffer();
      socket.forceHold();
      if (len > 0) {
        rc();
        len = 0;
      }
      socket.forceListen();
    } else if (len < CMD_LEN)
      buf[len++] = c;
  }
}
