thkrz/SenMei3000/arduino/sketches/ryujin/config.h

#ifndef _CONFIG_H
#define _CONFIG_H

#define LED_ORANGE 5

#define HOST "erdrutsch.com"
#define PATH "/station"
#define PORT 8000
#define USER_AGENT "Ryujin/1.0"

#define HTTP_TIMEOUT 15000L
#define HTTP_MSG_LEN 10

#define SDI_TIMEOUT 3000L

#define BAT_LOW 11.9

#endif /* _CONFIG_H */
