thkrz/SenMei3000/arduino/sketches/ryujin/gsm.h

#ifndef _GSM_H
#define _GSM_H

#define TINY_GSM_MODEM_SARAR4
// #define TINY_GSM_MODEM_UBLOX

#include <TinyGsmClient.h>

#define MODEM_TIMEOUT 8000L
#define MODEM_ON false
#define MODEM_OFF true

#endif /* _GSM_H */
