thkrz/SenMei3000/arduino/sketches/ryujin/WQ25LOG.cpp

#include "WQ25LOG.h"

#define SHIFT(a,n) ((a)+=3+(n))

WQ25LOG::WQ25LOG(int cs)
  : _flash(cs) {
}

void WQ25LOG::begin() {
  _flash.begin();

  _rp = 0;
  _wp = 0;
  while (_wp < _flash.getCapacity()) {
    uint16_t len = _flash.readWord(_wp + 1);
    if (len == 0xFFFF)
      break;
    SHIFT(_wp, len);
  }
}

bool WQ25LOG::append(String &s) {
  uint16_t len = s.length() + 1;

  if (_wp + 3 + len > _flash.getCapacity())
    return false;

  _flash.writeWord(_wp + 1, len);
  _flash.writeCharArray(_wp + 3, (char*)s.c_str(), len);

  SHIFT(_wp, len);
  return true;
}

void WQ25LOG::delete() {
  _flash.writeByte(_rp, 0x00);
}

bool WQ25LOG::format() {
  return _flash.eraseChip();
}

bool WQ25LOG::read(String &s) {
  while (_rp < _wp) {
    uint16_t len = _flash.readWord(_rp + 1);
    if (_flash.readByte(_rp) == 0xFF) {
      char buf[len];
      _flash.readCharArray(_rp + 3, buf, len);
      s = "";
      s += buf;
      return true;
    }
    SHIFT(_rp, len);
  }
  return false;
}

void WQ25LOG::seek(uint32_t a) {
  _rp = a;
}

void WQ25LOG::sleep(bool state) {
  if (state)
    _flash.powerDown();
  else
    _flash.powerUp();
}
