thkrz/SenMei3000/tools/ryujin-ctrl.py

#!/usr/bin/python3
import serial
import time
import sys


class COM:
    def __init__(self, port):
        self.com = serial.Serial(port)
        self.com.baudrate = 57600
        self.com.bytesize = 8
        self.com.parity = "N"
        self.com.stopbits = 1
        # self.com.timeout = 3.0

    def __enter__(self):
        return self

    def __exit__(self, exc_type, exc_value, traceback):
        self.close()

    def close(self):
        self.com.close()

    def write(self, s):
        self.com.write(s.encode())
        time.sleep(0.1)

    def read_chunk(self):
        s = self.read_until("#")
        self.com.reset_input_buffer()
        return s

    def read_until(self, eol):
        b = self.com.read_until(eol.encode())
        s = b.decode("utf-8")
        assert s.endswith(eol), "read error"
        return s[: -len(eol)]

    @property
    def timeout(self):
        return self.com.timeout

    @timeout.setter
    def timeout(self, n):
        self.com.timeout = n


if __name__ == "__main__":
    port = "/dev/ttyACM0"
    if len(sys.argv) > 2:
        port = sys.argv[1]

    with COM(port) as com:
        if sys.stdin.isatty():
            msg = sys.argv[-1]
        else:
            msg = sys.stdin.read().strip()
        if msg:
            com.write(msg)
            try:
                sys.stdout.write(com.read_chunk())
            except AssertionError:
                sys.exit(1)
