thkrz/SenMei3000/(commit log)

2024-12-15 Eye of the Beholder
    [Ryujin.kicad_pcb, Ryujin.kicad_sch]
2024-12-15 The Road to Calydon
    [Ryujin.kicad_pcb, Ryujin.kicad_sch]
2024-12-15 The Festival of Dionysus
    [Ryujin.kicad_pcb, Ryujin.kicad_sch]
2024-12-17 Pride Comes Before a Brawl
    [Ryujin.kicad_pcb, Ryujin.kicad_sch]
2024-12-19 As Darkness Falls
    [Ryujin.kicad_pcb]
2024-12-20 The March to Freedom
    [Ryujin.kicad_pcb, Ryujin.kicad_sch]
2024-12-20 The Warrior Princess
    [Ryujin.kicad_pcb]
2024-12-20 The Vanishing Dead
    [Ryujin.kicad_pcb, Ryujin.kicad_sch]
2024-12-20 The Gauntlet
    [Ryujin.kicad_pcb, Ryujin.kicad_sch]
2024-12-21 Unchained Heart
    [Ryujin.kicad_pcb, Ryujin.kicad_sch]
2024-12-21 What's in a Name?
    [Ryujin.kicad_pcb, Ryujin.kicad_sch]
2024-12-23 The King of Thieves
    [A2SDI12.kicad_pcb]
2024-12-23 Under the Broken Sky
    [A2SDI12.kicad_pcb]
2024-12-24 Cast a Giant Shadow
    [A2SDI12.kicad_pcb, A2SDI12.kicad_sch]
2024-12-25 Highway to Hades
    [A2SDI12.kicad_pcb, A2SDI12.kicad_sch]
2024-12-25 The Sword of Veracity
    [A2SDI12.kicad_pcb, A2SDI12.kicad_sch]
2024-12-25 The Enforcer
    [A2SDI12.kicad_pcb, A2SDI12.kicad_sch]
2025-01-21 The Mother of All Monsters
    [Ryujin.kicad_pcb, Ryujin.kicad_sch]
2025-01-22 Mother of All Monsters
    [Ryujin.kicad_pcb]
2025-01-22 The Other Side
    [Ryujin.kicad_pcb, Ryujin.kicad_sch]
2025-01-22 Heedless Hearts
    [FTSH-105-01-L-D-K.step, Ryujin.kicad_pcb, Ryujin.kicad_sch, SMKDSN-1-5-2-5-08_3D.step, SMKDSN-1-5-3-5-08_3D.step, SMKDSN-1-5-5-5-08_3D.step]
2025-01-23 Let the Games Begin
    [Ryujin.kicad_pcb, Ryujin.kicad_sch]
2025-01-23 The Fire Down Below
    [Ryujin.kicad_pcb, Ryujin.kicad_sch, SMKDSN-1-5-6-5-08_3D.step]
2025-01-23 The Apple
    [DBV0006A.step, Ryujin.kicad_pcb, Ryujin.kicad_sch]
2025-01-25 Protean Challenge
    [Ryujin.kicad_pcb, Ryujin.kicad_sch]
2025-01-25 The Power
2025-01-25 The Cave of Echoes
    [1869318.stp, A2SDI12.kicad_pcb, AoQin.kicad_pcb, AoQin.kicad_sch]
2025-01-26 Mummy Dearest
    [Ryujin.kicad_pcb, Ryujin.kicad_sch]
2025-01-26 Not Fade Away
    [Ryujin.kicad_sch]
2025-01-27 The Green-Eyed Monster
    [Ryujin.kicad_pcb]
2025-01-28 The Lady and the Dragon
    [Ryujin.kicad_pcb]
2025-01-31 Centaur Mentor Journey
    [MAX (STEP-AP214).STEP]
2025-02-02 The End of the Beginning
    [Ryujin.kicad_pcb, Ryujin.kicad_sch]
2025-02-03 War Bride
    [0.csv, 1.csv, Ryujin.kicad_pcb, Ryujin.kicad_sch, a.csv, b.csv, bat.csv, rh.csv]
2025-02-04 A Rock and a Hard Place
    [1_0.csv, 1_a.csv]
2025-02-04 Beanstalks and Bad Eggs
    [Ryujin.kicad_pcb, Ryujin.kicad_sch]
2025-02-05 Prince Hercules
    [1_0.csv]
2025-02-07 When a Man Loves a Woman
    [AoQin.kicad_pcb, AoQin.kicad_sch, FFKDSA1_V_381_3.stp, FFKDSA1_V_381_4.stp, SMKDSN_15_6_508.stp]
2025-02-07 Regrets… I've Had a Few
    [AoQin.kicad_pcb, AoQin.kicad_sch, SMKDSN_15_12_508.stp]
2025-02-07 Web of Desire
    [AoQin.kicad_pcb, AoQin.kicad_sch, SMKDSN_15_4_508.stp]
2025-02-07 Stranger in a Strange World
    [1_a.csv]
2025-02-08 Two Men and a Baby
    [AoQin.kicad_pcb]
2025-02-08 Prodigal Sister
    [AoQin.kicad_pcb, AoQin.kicad_sch]
2025-02-08 ...and Fancy Free
    [AoQin.kicad_pcb, AoQin.kicad_sch]
2025-02-09 If I Had a Hammer
    [2454982-4.stp, AoQin.kicad_pcb, AoQin.kicad_sch]
2025-02-10 Judgment Day
    [AoQin.kicad_pcb, AoQin.kicad_sch]
2025-02-10 The Lost City
    [AoQin.kicad_pcb, AoQin.kicad_sch]
2025-02-10 Medea Culpa
    [AoQin.kicad_pcb, AoQin.kicad_sch]
2025-02-10 Men in Pink
    [AoQin.kicad_pcb, AoQin.kicad_sch]
2025-02-11 Reign of Terror
    [1985218.stp, AoQin.kicad_pcb, AoQin.kicad_sch]
2025-02-11 Armageddon Now: Part 1
    [4116R-1-472LF.stp, AoQin.kicad_pcb, AoQin.kicad_sch]
2025-02-12 Armageddon Now: Part 2
    [AoQin.kicad_pcb, AoQin.kicad_sch]
2025-02-12 Hero's Heart
    [AoQin.kicad_pcb, AoQin.kicad_sch, NDS-06-V.stp]
2025-02-13 One Fowl Day
    [Ryujin.kicad_pcb, Ryujin.kicad_sch]
2025-02-14 War Wounds
    [Ryujin.kicad_pcb, Ryujin.kicad_sch]
2025-02-16 Top God
    [Ryujin.kicad_pcb, Ryujin.kicad_sch]
2025-02-18 Genies and Grecians and Geeks, Oh My
    [Ryujin.kicad_sch]
2025-02-18 Render Unto Caesar
    [Ryujin.kicad_sch]
2025-02-19 Norse by Norsevest
    [826632-2.stp, FFKDSA1_508_2.stp, FFKDSA1_508_3.stp, FTSH-105-01-L-D-K.step, Ryujin.kicad_pcb, Ryujin.kicad_sch, SMKDSN-1-5-2-5-08_3D.step, SMKDSN-1-5-3-5-08_3D.step]
2025-02-20 Darkness Rising
    [AoQin.kicad_pcb]
2025-02-20 For Those of You Just Joining Us
    [Ryujin.kicad_pcb, Ryujin.kicad_sch, SMKDSN_508_2.stp, SMKDSN_508_3.stp]
2025-02-20 Let There Be Light
    [Ryujin.kicad_pcb, Ryujin.kicad_sch, SMKDSN_508_6.stp]
2025-02-22 Sky High
    [Ryujin.kicad_pcb, Ryujin.kicad_sch]
2025-02-22 Stranger and Stranger
    [Ryujin.kicad_pcb, Ryujin.kicad_sch]
2025-02-22 Just Passing Through
    [Ryujin.kicad_pcb]
2025-02-22 Greece Is Burning
    [Ryujin.kicad_pcb]
2025-02-23 We'll Always Have Cyprus
    [Grove Connector (standing).STEP, Ryujin.kicad_pcb]
2025-02-23 The Academy
    [Ryujin.kicad_pcb]
2025-02-24 Love on the Rocks
    [Ryujin.kicad_pcb, Ryujin.kicad_sch]
2025-02-24 Once Upon a Future King
    [Ryujin.kicad_pcb, Ryujin.kicad_sch]
2025-02-24 Fade Out
    [Ryujin.kicad_pcb, Ryujin.kicad_sch]
2025-02-25 Hercules on Trial
    [ISP452.stp, Ryujin.kicad_pcb, Ryujin.kicad_sch]
2025-02-25 My Best Girl's Wedding
    [Ryujin.kicad_pcb, Ryujin.kicad_sch]
2025-02-26 Darkness Visible
    [cable-connector.kicad_pcb, cable-connector.kicad_sch]
2025-02-26 Hercules, Tramps & Thieves
    [Ryujin.kicad_pcb, Ryujin.kicad_sch]
2025-02-27 City of the Dead
    [Ryujin.kicad_pcb, Ryujin.kicad_sch]
2025-02-27 A Wicked Good Time
    [Ryujin.kicad_pcb, Ryujin.kicad_sch]
2025-02-28 Sins of the Past
    [1_0.csv, 1_1.csv, 1_2.csv, 1_a.csv]
2025-02-28 Chariots of War
    [Ryujin.kicad_pcb, Ryujin.kicad_sch]
2025-03-02 Cradle of Hope
    [Grove Connector (lying).STEP, cable-connector.kicad_pcb, cable-connector.kicad_sch]
2025-03-04 Death in Chains
2025-03-06 Beware Greeks Bearing Gifts
    [Ryujin.kicad_pcb, Ryujin.kicad_sch]
2025-03-06 Athens City Academy of the Performing Bards
    [Ryujin.kicad_pcb, Ryujin.kicad_sch]
2025-03-07 A Fistful of Dinars
    [Ryujin.kicad_sch]
2025-03-08 Mortal Beloved
    [Ryujin.kicad_pcb, Ryujin.kicad_sch]
2025-03-09 The Royal Couple of Thieves
    [Ryujin.kicad_pcb, Ryujin.kicad_sch]
2025-03-09 The Prodigal
    [Ryujin.kicad_pcb, Ryujin.kicad_sch]
2025-03-09 Altared States
    [Ryujin.kicad_sch]
2025-03-09 Ties That Bind
    [22-03-5045.stp, Ryujin.kicad_pcb]
2025-03-09 The Greater Good
    [Ryujin.kicad_pcb, Ryujin.kicad_sch]
2025-03-09 Orphan of War
    [Ryujin.kicad_pcb]
2025-03-10 Remember Nothing
    [Ryujin.kicad_pcb, Ryujin.kicad_sch]
2025-03-11 The Giant Killer
    [Ryujin.kicad_pcb, Ryujin.kicad_sch]
2025-03-11 Girls Just Wanna Have Fun
    [Ryujin.kicad_pcb, Ryujin.kicad_sch]
2025-03-12 Somewhere Over the Rainbow Bridge
    [Ryujin.kicad_pcb, Ryujin.kicad_sch]
2025-03-12 Return of Callisto
    [Ryujin.kicad_pcb, Ryujin.kicad_sch]
2025-03-14 Ten Little Warlords
    [Ryujin_v2.kicad_pcb, Ryujin_v2.kicad_sch]
2025-03-14 A Solstice Carol
    [Ryujin_v2.kicad_pcb]
2025-03-15 The Xena Scrolls
    [22-03-5045.stp, 5236CDB.stp, 6-534237-2.step, Battery_Charger.kicad_sch, DBV0006A.step, FFKDSA1_508_2.stp, FFKDSA1_508_3.stp, Grove Connector (lying).STEP]
2025-03-15 Here She Comes... Miss Amphipolis
    [Ryujin.kicad_pcb]
2025-03-15 The Quest
    [FFKDSA1_508_2.stp, FFKDSA1_508_3.stp, Grove Connector (standing).STEP, ISP452.stp, PT_25_4_75_V.stp, RVA0016A.stp, Ryujin.kicad_pcb, Ryujin.kicad_sch]
2025-03-15 A Necessary Evil
    [AoQin.kicad_pcb, AoQin.kicad_sch, Ryujin.kicad_pcb]
2025-03-15 A Day in the Life
    [Ryujin.kicad_pcb]
2025-03-16 For Him the Bell Tolls
    [1985195.stp, Battery_Charger.kicad_sch, Molex_Micro-Fit_3.0_43650-0415_1x04_P3.00mm_Vertical.stp, Ryujin.kicad_pcb, Ryujin.kicad_sch]
2025-03-16 The Execution
    [Battery_Charger.kicad_sch]
2025-03-16 Blind Faith
    [BQ24650RVAR.stp, Battery_Charger.kicad_sch, IHLP2525CZER100MA1.stp, PDS1040-13.stp, Ryujin.kicad_pcb]
2025-03-16 The Price
    [Battery_Charger.kicad_sch, Ryujin.kicad_pcb, Ryujin.kicad_sch]
2025-03-17 Lost Mariner
    [Battery_Charger.kicad_sch, Ryujin.kicad_pcb, Ryujin.kicad_sch]
2025-03-17 The Furies
    [Battery_Charger.kicad_sch, Ryujin.kicad_pcb, Ryujin.kicad_sch]
2025-03-17 Been There, Done That
    [Ryujin.kicad_pcb]
2025-03-18 Be Deviled
    [Ryujin.kicad_pcb, pieces.xlsx]
2025-03-18 Love, Amazon Style
    [Ryujin.kicad_pcb]
2025-03-18 The Dirty Half Dozen
    [Battery_Charger.kicad_sch, Ryujin.kicad_pcb, Ryujin.kicad_sch]
2025-03-18 The Deliverer
    [Battery_Charger.kicad_sch, Ryujin.kicad_pcb]
2025-03-19 Rebel with a Cause
    [Ryujin.kicad_pcb, SonTinh.kicad_pcb, SonTinh.kicad_sch]
2025-03-19 Gabrielle's Hope
    [1869318.stp, 1985195.stp, 2454982-4.stp, 4116R-1-472LF.stp, AoQin.kicad_pcb, AoQin.kicad_sch, FFKDSA1_V_381_3.stp, FFKDSA1_V_381_4.stp]
2025-03-19 The Debt, Part 1
    [1869318.stp, 2454982-4.stp, 4116R-1-472LF.stp, FFKDSA1_V_381_3.stp, FFKDSA1_V_381_4.stp, SMKDSN_15_12_508.stp, SMKDSN_15_4_508.stp, SMKDSN_15_6_508.stp]
2025-03-19 The Debt, Part 2
    [SonTinh.kicad_pcb]
2025-03-20 The King of Assassins
    [1822972.stp, AoQin.kicad_pcb, AoQin.kicad_sch, Ryujin.kicad_pcb, Ryujin.kicad_sch]
2025-03-20 Warrior… Priestess… Tramp
2025-03-21 The Quill Is Mightier…
    [SonTinh.kicad_pcb, SonTinh.kicad_sch]
2025-03-22 The Bitter Suite
    [SonTinh.kicad_pcb, SonTinh.kicad_sch]
2025-03-22 One Against an Army
    [Ryujin.kicad_pcb]
2025-03-23 King Con
    [Ryujin.kicad_pcb]
2025-03-23 When in Rome...
    [Ryujin.kicad_pcb]
2025-03-23 Forget Me Not
    [Battery_Charger.kicad_sch, Ryujin.kicad_pcb, Ryujin.kicad_sch]
2025-03-24 Full Circle
    [Battery_Charger.kicad_sch, Ryujin.kicad_pcb, Ryujin.kicad_sch, SI7288DP-T1-GE3.stp]
2025-03-24 The Path Not Taken
    [SonTinh.kicad_pcb]
2025-03-24 Fins, Femmes and Gems
    [Ryujin.kicad_pcb, SonTinh.kicad_pcb]
2025-03-25 The Reckoning
    [AoQin.kicad_pcb, AoQin.kicad_sch, SonTinh.kicad_pcb, SonTinh.kicad_sch]
2025-03-26 Vanishing Act
    [Ryujin.kicad_pcb]
2025-03-27 The Titans
    [SonTinh.kicad_pcb, SonTinh.kicad_sch]
2025-04-04 Hooves & Harlots
    [1071184.psm, 1861959.stp, AoQin.kicad_pcb, AoQin.kicad_sch, EDI2CAP.CFG, chips.prt]
2025-04-04 Sacrifice, Part 1
    [1071184.psm, EDI2CAP.CFG, chips.prt]
2025-04-10 Warrior... Princess
    [SonTinh.kicad_pcb, SonTinh.kicad_sch]
2025-05-07 Death Mask
    [Ryujin.kicad_sch]
2025-05-09 Is There a Doctor in the House?
    [Battery_Charger.kicad_sch, Ryujin.kicad_pcb, Ryujin.kicad_sch]
2025-05-14 In Sickness and in Hell
    [Ryujin.kicad_pcb]
2025-05-15 A Tale of Two Muses
    [Battery_Charger.kicad_sch, Ryujin.kicad_pcb, Ryujin.kicad_sch]
2025-05-15 Past Imperfect
    [Ryujin.kicad_pcb, Ryujin.kicad_sch]
2025-05-15 Daughter of Pomira
    [Ryujin.kicad_pcb]
2025-06-02 The Convert
    [Battery_Charger.kicad_sch, Ryujin.kicad_pcb, Ryujin.kicad_sch]
2025-08-25 Little Problems
    [1751248.stp, 1751251.stp, 1868128.stp, SonTinh.kicad_pcb, SonTinh.kicad_sch]
2025-08-27 God Fearing Child
    [Ryujin.kicad_sch]
2025-08-27 Eternal Bonds
    [Ryujin.kicad_sch]
2025-09-04 Coming Home
    [Ryujin.kicad_pcb, Ryujin.kicad_sch, T522V227M006ATE025.stp]
2025-09-04 Heart of Darkness
    [Ryujin.kicad_pcb, Ryujin.kicad_sch]
2025-09-05 Sacrifice, Part 2
    [AS11CH.stp]
2025-09-05 Adventures in the Sin Trade, Part 2
    [Battery_Charger.kicad_sch, Ryujin.kicad_pcb, Ryujin.kicad_sch]
2025-09-05 Return of the Valkyrie
    [SonTinh.kicad_sch]
2025-09-06 Old Ares had a Farm
    [Battery_Charger.kicad_sch, Ryujin.kicad_pcb, Ryujin.kicad_sch, SonTinh.kicad_pcb, SonTinh.kicad_sch, volt_supp.kicad_sch]
2025-09-06 Dangerous Prey
    [SonTinh.kicad_pcb, SonTinh.kicad_sch]
2025-09-06 The God you Know
    [SonTinh.kicad_sch]
2025-09-07 Path of Vengeance
    [SonTinh.kicad_pcb, SonTinh.kicad_sch]
2025-09-12 Soul Possession
    [Ryujin.kicad_pcb, volt_supp.kicad_sch]
2025-09-12 A Friend in Need, Part 1
    [Ryujin.kicad_pcb, volt_supp.kicad_sch]
2025-09-12 A Friend in Need, Part 2
    [Ryujin.kicad_pcb, Ryujin.kicad_sch, gps.kicad_sch, volt_supp.kicad_sch]
2025-09-12 To Be Or Not To Be
    [SonTinh.kicad_pcb, SonTinh.kicad_sch, gps.kicad_sch]
2025-09-13 Treasure of The Mind
    [Ryujin.kicad_sch, gps.kicad_sch]
2025-09-13 Treasures of the Tonga Trench
    [gps.kicad_sch]
2025-09-15 A Family Affair
    [Ryujin.kicad_sch, volt_supp.kicad_sch]
2025-09-16 Give Me Liberté
    [Ryujin.kicad_pcb, Ryujin.kicad_sch, volt_supp.kicad_sch]
2025-09-17 The Regulator
